pieterseyale-eng/PAROL6-Desktop-robot-arm/3D打印/临时联轴器试装/README.md

# 8 mm 法兰联轴器临时试装件

文件 `8mm法兰联轴器_试装.stl` 可直接导入 Bambu Studio；`8mm法兰联轴器_试装.scad` 是可修改尺寸的参数化源文件。

## 尺寸依据

用户提供的已购商品图：法兰外径 32 mm、厚 3 mm，轴套外径 16 mm、长 10 mm，公称轴孔 8 mm，4 个 4 mm 光孔、对孔中心距 24 mm，侧面 M4 顶丝。原 PAROL6 的 J2、J3、J6 配合 STL 实测也是 4 孔、孔距圆 24 mm。装配手册第 62、94、97 页分别列出 J2、J3、末端的联轴器安装。

打印试装 STL 为适应 FDM，把轴孔放大到 8.2 mm、四个安装光孔放大到 4.2 mm；侧向 M4 顶丝孔为 3.3 mm 打印攻丝底孔。两侧向孔按 90° 分布，是依据图片做的临时假设，到货后以实物为准。若打印机孔径偏小，请先测量，不要硬敲输出轴。

这个打印件只用于孔位、外形、装配空间和低负载手动试配。J2、J3 的实际传扭和承重仍需金属联轴器；不要用打印件通电带载运行机械臂。
