pieterseyale-eng/PAROL6-Desktop-robot-arm/parol6_description （机器人模型说明）/parol6_description/docs/README.md

# Package documentation

[Back to the model instructions](../README.md)

- [Position actuation and open-loop hardware](ACTUATION.md)
- [Model license and attribution](ATTRIBUTION.md)
- [PAROL6 description changelog](CHANGELOG.md)
- [Changing model colors](COLORS.md)
- [Local contact-refinement timing check](CONTACT_PERFORMANCE.md)
- [PAROL6 DH and joint convention](DH.md)
- [PAROL6 dynamics inheritance](DYNAMICS.md)
- [PAROL6 inheritance and normalized-frame validation](DYNAMICS_AUDIT.md)
- [Jaw-specific grasp frames: proposed implementation](GRASP_FRAMES.md)
- [PAR6 and PAROL6: common DH and joint convention](KINEMATICS_COMPARISON.md)
- [PAROL6 kinematic review sheets](KINEMATIC_REVIEW.md)
- [Importing the supplied PAROL6 export](MIGRATION.md)
- [MoveIt 2: plan and preview robot movements](MOVEIT2.md)
- [View from the MSG built-in camera](MSG_CAMERA.md)
- [Pneumatic gripper](PNEUMATIC.md)
- [ROS 2: install and display the models](ROS2.md)
- [SSG48 internal contacts and grasp fixture correction](SSG48_CONTACTS.md)

[Dimensioned SVG/PNG sheets and numeric data](kinematics_review/)
