pieterseyale-eng/PAROL6-Desktop-robot-arm/Docs （项目文档）/wrist_C_B电机插头避让_修改记录.md

# wrist 电机插头避让：B、C 两面开槽

日期：2026-11-11。依据 J6 实物试装照片，两处插头与 `wrist.STL` 开口附近的侧壁干涉。用户根据开口俯视定位图确认需要切 **B 面（+X）与 C 面（+Y）**。

## 几何参数

- 原 STL 坐标单位：mm；开口位于最小 Z，即 `Z = 0.090815`。
- 电机方腔中心按截面取 `X = 30.05`、`Y = 29.10`。
- 每处槽口沿所在侧壁宽 **25 mm**，从开口沿电机轴线向内深 **25 mm**。切除终点为 `Z = 25.090815`。
- C 面槽口：X 为 `17.55～42.55`；切除刀具跨越 Y 为 `46.5～61.5`，穿透该面壁厚。
- B 面槽口：Y 为 `16.60～41.60`；切除刀具跨越 X 为 `48.5～63.5`，穿透该面壁厚。
- 刀具从开口外侧延伸 2 mm，确保完全切开开口边缘；模型的总体包围盒不变。

## 文件

- 原模型：`STL （三维打印模型）/WRIST （腕部）/wrist.STL`
- 修改后的源模型：`STL （三维打印模型）/WRIST （腕部）/wrist_C_B_connector_relief_25x25.STL`
- 当前打印版：`3D打印/分锅STL/锅07_腕部急停盒与J2/wrist_C_B_connector_relief_25x25.STL`
- 原打印版备份：`3D打印/备份/wrist_原版.STL`
- 复现脚本：`3D打印/修改脚本/wrist_C_B_开槽.py`
- 截面对比：`STL （三维打印模型）/WRIST （腕部）/wrist_C_B_开槽截面对比.png`

## 核对结果

- 原版体积 `83455.017 mm³`；新版体积 `76566.660 mm³`；切除约 `6888.358 mm³`。
- 新版为单一连通、闭合网格，外形包围盒未变化。
- 打印副本与新版源模型的 SHA-256 一致：`12db9f6008aab9d4d46d5325466b9ca72d94eb5f18c9e2d8f9e1308a720c1818`。
- 原打印版备份与原始源模型逐字节一致。

首次打印后仍需用实物试装，确认两个插头及线束弯曲半径有足够余量；照片不能提供插头的精确三维尺寸。
