pieterseyale-eng/PAROL6-Desktop-robot-arm/Docs （项目文档）/项目进度.md

# PAROL6 项目进度

更新日期：2026-11-06
当前阶段：**材料已购齐，拓竹 P1S 已调试好，准备开始打印机械件**。

## 已完成

- 已将 PAROL6 官方仓库克隆到本地，在 `dev/custom-controller` 分支开发；官方仓库保留为 `upstream`，个人 fork 为 `origin`。
- 已整理中文采购资料、标准件备货表和中文装配手册。
- 本阶段所需材料已采购齐全（按项目负责人 2026-11-06 的进度确认）。气动末端此前决定暂不做，不计入这一阶段。
- 实验室打印机为 **Bambu Lab P1S**，已完成调试，准备开始打印。
- 已将打印用 STL 按锅整理到 [`3D打印/分锅STL`](../3D打印/分锅STL)，并写了 [P1S 分锅方案](P1S打印分锅方案.md) 和 [打印操作说明](../3D打印/README.md)。分锅 STL 仍需在 Bambu Studio 中按实际耗材、喷嘴和打印板切片。
- 已下载官方 PAROL6 URDF 模型包 v2.18.1，保存在 [`parol6_description` 模型目录](../parol6_description%20%EF%BC%88%E6%9C%BA%E5%99%A8%E4%BA%BA%E6%A8%A1%E5%9E%8B%E8%AF%B4%E6%98%8E%EF%BC%89/parol6_description)。

## 下一步：开始打印

1. 确认零件版本：整件上臂与小平台分体上臂二选一；J1 标准件与改装件按实际方案选用，避免重复打印。
2. 按锅将对应 STL 一起导入 Bambu Studio，选择 P1S 和实际 PETG 耗材配置，核对方向、支撑、零件间距与切片预览后再打印。
3. 记录每锅打印结果及尺寸配合问题；承力件和轴承座先试装，再继续后续锅次。
4. J6 将使用张大头闭环电机相关方案，原估算轴向长度为减速器 55 mm＋电机 23 mm＋尾部控制板约 20 mm，合计约 98 mm（不含输出轴）。Link5/J6 机械结构仍需按实物尺寸修改；现有 J6 原版打印件不应视作最终改版件。

## 本阶段记录原则

- 本页记录实际进度；采购金额在本目录的 `PAROL6_采购财务台账.xlsx` 中单独记录。
- 打印结束后，在本页补记每锅日期、材料、是否成功、返工件和装配发现。
