pieterseyale-eng/PAROL6-Desktop-robot-arm/Docs （项目文档）/P1S打印分锅方案.md

# PAROL6 × 拓竹 P1S 打印分锅方案

设备：Bambu Lab P1S，标称成型空间 256 × 256 × 256 mm（[拓竹官方产品页](https://bambulab.com/en/p1)）。下表尺寸为当前仓库 STL 网格包围盒，单位 mm；并非推荐朝向下的实际占板尺寸。此方案是分锅草案，尚未在 Bambu Studio 实际排版。

## 打印前的选择

- 正常版主体件可逐件放入 P1S。整件 `Upper_arm.STL` 包围盒为 102 × 231 × 28 mm，长边沿平台 256 mm 方向摆放时只剩约 12.5 mm 总余量；建议单独打印并检查裙边、Brim 和边缘避让。
- 小平台目录中的分体上臂是整件上臂的替代方案，不要两套都打印。J1 标准件、rework blocker 和 small-bed 分体件也应按所选结构版本择一。
- 气动/真空夹爪附件暂不列入主体打印计划。
- 主体结构件建议使用 PETG，并遵循耗材厂商的温度、干燥要求和项目打印参数。具体温度、墙数、填充率要按实际耗材和切片结果设定，不能把单一值视为所有 PETG 通用参数。

## 正常整件方案分锅

| 锅次 | 零件（各 1 件，除注明外） | 摆放建议 |
|---|---|---|
| 1 底座主件 | `main_base_blocker` (118×107×70)；`Electronics_case_v1_1` (109×60×130)；`fan_cover` (53×60×22) | 两个主件在同板排布，检查 brim 是否干涉；风扇盖填边角空位。若大件需要大量支撑，拆成两锅更稳妥。 |
| 2 底座盖和 J1 小件 | `lid_electronics` (105×107×10)；`J1_bottom_lid` (62×63×5)；`J1_rotation_shaft` (35×41×35)；`J1_turret_motor_holder` (55×20×55)；`J1_backplate` (46×7×46) | 薄盖平放；轴/支架依受力方向摆放。检查支撑不要堵紧固孔。 |
| 3 J1 改装大件 | `J1_turret_rework_blocker` (114×175×75) | 单独打印并检查支撑、Brim 和受力层向。仅在选用该 rework 结构时打印；标准 J1 方案不要重复打。 |
| 4 上臂 | `Upper_arm` (102×231×28)；可搭 `38_pulley_J3` (40×40×38)、`J3_limit_switch_cover` (40×32×7)、`Upper_arm_wires_cover` (39×33×7) | 上臂单独占主要区域，长边沿 256 mm 方向。小件只在摆盘后仍有充分间隙时加入。采用分体上臂时改打 A/B 两段，不打整件。 |
| 5 肘部和 J4 | `Elbow_part` (65×102×107)；`Elbow_lid_1` (65×67×8)；`Elbow_lid_2` (48×29×3)；`J4_bearing_backplate` (38×38×6)；`J4_limiter` (10×12×6)；`J4_output_pulley` (45×45×60) | 肘部主件摆放优先考虑层间受力；盖板和滑轮可尝试同锅。核对轴承/轴孔方向及支撑可拆性。 |
| 6 前臂和 J5 | `J5_part` (134×71×74)；`J5_belt_lid` (121×57×15)；`J5_electronics_lid` (50×71×38)；`HTD3_48_J5_pulley` (45×45×26) | 大件和盖、滑轮尝试同锅，使用切片器排版并检查部件间距。若支撑复杂可把盖板/滑轮移到下一锅。 |
| 7 腕部、急停盒、J2 | `wrist` (57×54×81)；`ESTOP_BOTTOM` (48×48×24)；`ESTOP_TOP` (48×21×48)；`J2_bearing_backplate` (47×6×47)；`J2_cover` (60×12×60)；`J2_shaft` (35×48×35)；`J2_stopper_block` (40×46×11)；`J2_limit_switch_cover` (40×21×5)；`42_pulley` (16×41×41) | 小中件可尝试同板。腕部与轴件按受力层向摆放；若板面过密，分成两锅降低整板失败风险。 |
| 8 小辅件/补打 | `connectors_4_alu_profiles` (30×30×30)；`J1_wires_cover_rework` (9×106×6) 及最终选定版本所需小件 | 可填入其他锅次的空位。rework 线盖只在对应改装方案下打印。 |

## 小平台分体替代件

- 上臂：`SMALL_PRINT_BED/Upper_arm/Upper_arm_A_long_end` (82×162×28) 与 `Upper_arm_B_short_end` (77×88×28) **替代** `Upper_arm.STL`。可将 A 段与一锅主件同板，B 段与盖板/小件同板，但须在切片器确认占板与受力方向。
- J1：`J1_turret_rework_blocker_A_turret_end` (100×105×53) 与 `_B_arm_end` (114×80×75) 替代整体 rework blocker。按该目录 README 和小平台改装手册核定配套关系，不要当作额外加强件打印。

## P1S 上机核对

1. 在 Bambu Studio 选择 P1S 与实际喷嘴，逐锅导入并自动排版；逐件检查朝向、Brim、支撑、孔位和部件间距。
2. 先打印 `Elbow_part`、`J5_part` 等配合/承力复杂件样件，检查孔轴、轴承座、层间裂纹和装配尺寸，再批量打印。
3. PETG 先按线轴厂商说明干燥，并使用相应耗材配置；按拓竹对设备和耗材的建议控制腔温与通风。不同品牌耗材参数可能不同。
4. 项目打印说明和打印参数表作为强度设置参考；最终耗材、工时、支撑和裙边由切片器预览确认。提高填充率不能替代正确打印方向和外墙设计。
5. 打印时记录实际方向、耗材和失败/返工件；不同受力方向或支撑策略差异大的关键件可拆锅。

## 范围和限制

本方案根据 STL 网格包围盒作初步分组，未生成 3MF，也未计算实际耗材或工时。STL 自带方向未必是最佳打印方向；悬垂、支撑、Brim 与平台边缘余量必须由 Bambu Studio 确认。仓库包含替代件和夹爪附件，45 个 STL 不等于 45 个装机件；请按所选机械版本、README 和装配手册确定实际打印清单。
