pieterseyale-eng/PAROL6-Desktop-robot-arm/Docs （项目文档）/目录中英对照.md

# 目录中英对照

目录保留英文原名，并附加中文说明。文件名保持不变。
本次范围：项目根目录的普通文件夹，以及物料清单、STL、扩展功能和模型说明中的分类目录。
Git 管理目录、`.github` 和源码内部工具/第三方库目录保留约定名称。
官方镜像 `../../PAROL6-official.git` 保留原始目录结构。

| 原目录 | 当前目录 |
| --- | --- |
| `BOM` | `BOM （物料清单）` |
| `BOM/BOM reference images` | `BOM （物料清单）/BOM reference images （物料参考图片）` |
| `Building instructions` | `Building instructions （装配说明）` |
| `Docs` | `Docs （项目文档）` |
| `Extras` | `Extras （扩展功能）` |
| `Extras/LEAP motion control code` | `Extras （扩展功能）/LEAP motion control code （LEAP手势控制代码）` |
| `Images` | `Images （图片资料）` |
| `PAROL6 control board main software` | `PAROL6 control board main software （主控正式固件）` |
| `PAROL6 control board test code` | `PAROL6 control board test code （主控测试固件）` |
| `Print table` | `Print table （打印参数表）` |
| `STL` | `STL （三维打印模型）` |
| `STL/BASE` | `STL （三维打印模型）/BASE （底座）` |
| `STL/ELBOW` | `STL （三维打印模型）/ELBOW （肘部）` |
| `STL/ESTOP` | `STL （三维打印模型）/ESTOP （急停盒）` |
| `STL/FOREARM` | `STL （三维打印模型）/FOREARM （前臂）` |
| `STL/GRIPPER_ATTACHMENTS` | `STL （三维打印模型）/GRIPPER_ATTACHMENTS （夹爪连接件）` |
| `STL/GRIPPER_ATTACHMENTS/Horizontal pneumatic gripper` | `STL （三维打印模型）/GRIPPER_ATTACHMENTS （夹爪连接件）/Horizontal pneumatic gripper （水平气动夹爪）` |
| `STL/SHOULDER` | `STL （三维打印模型）/SHOULDER （肩部）` |
| `STL/SMALL_PRINT_BED` | `STL （三维打印模型）/SMALL_PRINT_BED （小尺寸打印平台）` |
| `STL/SMALL_PRINT_BED/J1_turret_rework_blocker` | `STL （三维打印模型）/SMALL_PRINT_BED （小尺寸打印平台）/J1_turret_rework_blocker （J1转台限位件）` |
| `STL/SMALL_PRINT_BED/Upper_arm` | `STL （三维打印模型）/SMALL_PRINT_BED （小尺寸打印平台）/Upper_arm （上臂）` |
| `STL/UPPER_ARM` | `STL （三维打印模型）/UPPER_ARM （上臂）` |
| `STL/UTILITY` | `STL （三维打印模型）/UTILITY （辅助零件）` |
| `STL/WRIST` | `STL （三维打印模型）/WRIST （腕部）` |
| `STL/mounting plates` | `STL （三维打印模型）/mounting plates （安装板）` |
| `parol6_description` | `parol6_description （机器人模型说明）` |
| `parol6_description/previews` | `parol6_description （机器人模型说明）/previews （预览图）` |
