pieterseyale-eng/PAROL6-Desktop-robot-arm/硬件资料/张大头/PAROL6选型与控制方案.md

# 张大头闭环步进资料与 PAROL6 适配结论

## 归档资料

本文件夹收录：

- `ZDT_X42S第二代闭环步进电机用户手册V1.0.5_260527.pdf`：X42S 说明书，110 页。
- `ZDT闭环步进电机MODBUS协议使用说明V1.0.1_260818.pdf`：Modbus-RTU 通讯手册。
- `ZDT闭环步进电机选型表_251105.jpg`：文件名叫“选型表”，图中实际内容主要是 X42_V1.3、X42S_V1.0、Y42_V2.0 板卡与 Emm/X 固件对比，不是电机尺寸/扭矩选型表。

## 先给结论

张大头 X42S 的闭环驱动和通讯能力可以接入自研主控，方向上适合做六轴的位置控制；但当前这批资料**不足以确认你准备购买的五个具体电机够不够 PAROL6 承载，也不足以确认其外形能否装进 J1–J5**。资料说的是驱动板能力，缺少所选 42 磁柱电机型号对应的保持/动态扭矩曲线、机身长度、轴径与轴伸，以及装上编码器板后的总长。建议向商家明确要逐个电机型号的尺寸图与转速-扭矩曲线，并询问能否 X42S_V1.0 驱动板与配套磁柱电机整套安装校准发货。

## 怎么控制：建议架构

推荐每轴一套“42 步进电机 + X42S 闭环驱动板”，主控 MCU 用 **CAN 总线**连接五轴（未来第六轴也一样接入）。CAN 线采用总线拓扑，所有节点共用 CAN_H、CAN_L 和信号地，配置唯一节点地址/ID，并只在总线两端按手册要求配置终端电阻。若买到的是 RS485 版本，则使用 RS485 差分总线与唯一电机地址；不要买错通讯小板/集成接口版本。TTL 更适合短距离台架测试，不作为整臂首选。

控制层由你自己的主控产生每个关节的目标角度/速度/加速度；驱动器内部负责电机电流、编码器反馈和位置闭环。主控读取实际位置、位置误差、转速、状态/报警及温度等反馈，做状态机和故障处理。X42S 手册说明支持 CAN/RS485/TTL 通讯、位置/速度/力矩等模式、周期状态回传、多电机命令和同步启动。开发初期可先用厂家自由协议跑通，再考虑 Modbus-RTU；Modbus 通讯手册单独列出了读状态寄存器、读写参数等方法。若采用 CAN，要按主手册 CAN 帧格式而不是把 Modbus RTU 帧直接塞进 CAN。

关节目标角度的换算要放在你的主控里：

- J1（皮带）：电机角度和关节角度按 96/15 的带轮比换算。
- J2：电机经 20:1 行星减速器，关节角约为电机角度 / 20。
- J3：行星减速器与带传动组合，仓库现有配置约 18.095:1（20 × 42/38）；具体正负方向按装配后标定。
- J4/J5（皮带）：按实际电机轮/关节轮齿数换算；原机械参考电机 12T，主传动轮分别需对照 CAD/BOM 复核。

上面只给理想传动比例，运动方向、零位偏置和限位范围要在组装后逐轴标定。**电机端编码器不等于关节输出端绝对角度传感器**：减速器回差、皮带弹性和连杆形变仍在编码器测量之外。若要评估真实末端误差，后续可在关键关节输出侧加编码器。

## 推荐购买/下单配置

1. 询价时先明确要 **X42S_V1.0**（不要误买旧 X42_V1.3；后者已停产）及通讯接口版本。若自研板支持 CAN，优先询价 CAN 集成/套件；问清总线速率、接口针脚、线束和节点地址设置方式。
2. J1–J5 暂按仓库机械尺寸寻找匹配的 42 系列步进电机：J1/J2 原参考机身约 60 mm，J3/J4/J5 原参考约 40 mm。需厂家确认“装驱动器/编码器后的总长”，不能只看 42 mm 法兰或电机裸机身长度。
3. J2/J3 需保留/适配原有 NEMA17 20:1 行星减速器。下单前确认 X42S 配套电机的轴径、轴伸、前端法兰和螺钉孔与减速器输入兼容；J3 的总传动比还包含皮带级。
4. J1/J4/J5 保留皮带级时，需确认输出轴加工形状、齿轮/同步轮紧固方式与电机空间。闭环板在电机尾部的空间也要纳入机构包络。
5. J6 由你调整 Link5 机械结构，可与五轴分开选型；不要因同属 42 系列就认为 J6 也能用相同长度/扭矩版本。
6. 扭矩不能凭 X42S 驱动板最大电流推断。先根据臂展和各轴重力力矩选电机，再用厂家动态扭矩曲线核对低速连续保持与运动速度下的输出；肩部还要计入整条手臂自重、夹爪和加速度。

## 调试顺序建议

1. 单独给每套驱动板和电机接线，检查绕组线序、供电版本与接口板版本；严禁带电插拔电机/电源/通讯线。
2. 电机与驱动板按厂家要求装好后，先在空载条件下做编码器/电机校准；拆过板、换过电机后重新校准。
3. 在桌面固定、低速度、小角度下用通讯工具测试单轴：使能、目标位置、停止、读实际位置、读状态和报警。
4. 给每轴配置唯一地址；单轴稳定后再测试总线多轴命令与同步启动。
5. 装到机械臂后逐轴校零、限位和方向，验证急停/掉线处理及软限位，再低速试整臂。

## 需要卖家补齐的资料

- J1/J2 长机身候选和 J3/J4/J5 中机身候选的准确型号与价格。
- 每个型号的整机尺寸图（含编码器/驱动板）、轴径/轴伸/扁位、安装孔距。
- 保持扭矩及动态扭矩-转速曲线，额定电流和建议电源。
- X42S_V1.0 的具体通讯接口选择：CAN 或 RS485，是否集成，线序/端子图和配套线缆。
- CAN/RS485 的多机控制例程、默认 ID、波特率、应答模式，以及同步命令在该固件版本下的支持方式。
- 五套电机与驱动板能否整套安装、校准后发货；若自行安装，所需磁铁/胶、间隙和校准步骤。
