pieterseyale-eng/PAROL6-Desktop-robot-arm/parol6_description （机器人模型说明）/parol6_description/docs/ATTRIBUTION.md

# Model license and attribution

Copyright 2026 Source Robotics.

The robot/gripper descriptions, geometry, textures, physical data and
documentation in this package are licensed under **CC-BY-4.0**.
See the [full model license](../LICENSE).

Source: [Source Robotics robot_descriptions](https://github.com/Source-Robotics/robot_descriptions).
License: [Creative Commons Attribution 4.0 International](https://creativecommons.org/licenses/by/4.0/).

When sharing the models or adaptations, credit Source Robotics, link to the
source and license, retain supplied notices, and indicate your changes.
For example:

> Robot models by Source Robotics, https://github.com/Source-Robotics/robot_descriptions,
> CC BY 4.0, https://creativecommons.org/licenses/by/4.0/.
> Changes: describe your modifications, or state that none were made.

ROS launch/support scripts and CMake code are Apache-2.0; see [LICENSE-CODE.txt](LICENSE-CODE.txt).
