pieterseyale-eng/PAROL6-Desktop-robot-arm/Docs （项目文档）/法兰联轴器_已购商品尺寸图.png

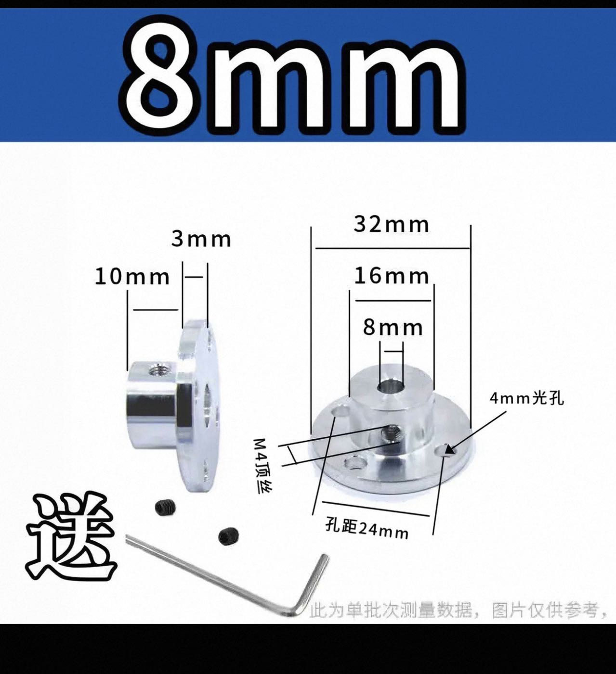
Docs （项目文档）/法兰联轴器_已购商品尺寸图.png
