pieterseyale-eng/PAROL6-Desktop-robot-arm/Docs （项目文档）/螺钉头型参考图/cross_pan_head_reference.png

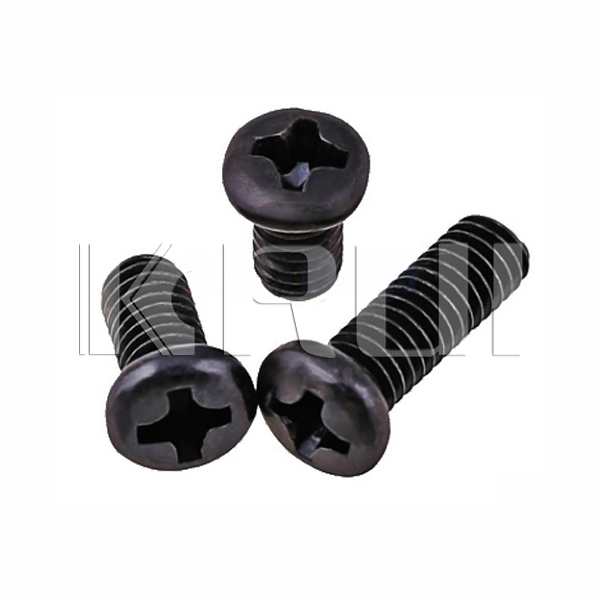
Docs （项目文档）/螺钉头型参考图/cross_pan_head_reference.png
