pieterseyale-eng/PAROL6-Desktop-robot-arm/Docs （项目文档）/螺钉头型参考图/low_profile_head_reference.webp

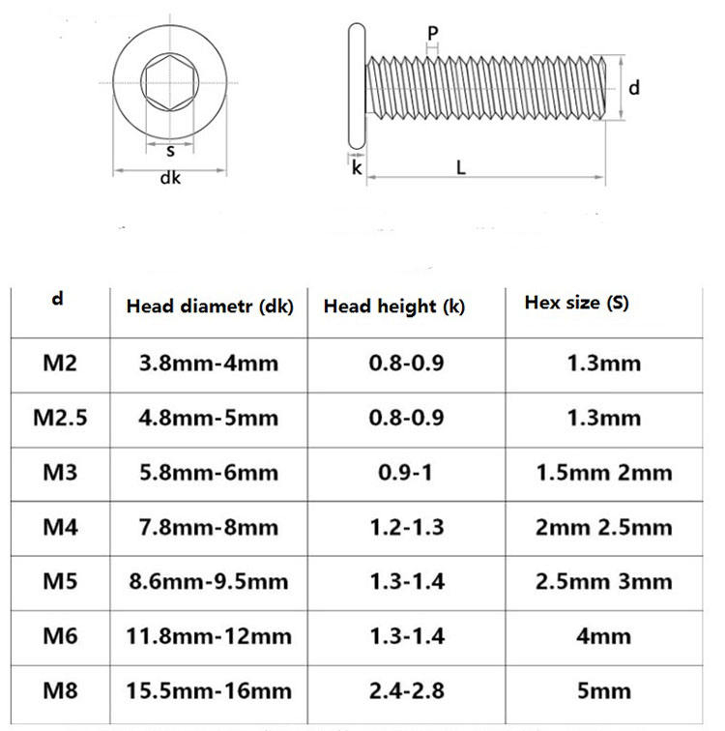
Docs （项目文档）/螺钉头型参考图/low_profile_head_reference.webp
