pieterseyale-eng/PAROL6-Desktop-robot-arm/Docs （项目文档）/螺钉头型参考图/tapered_head_reference.jpeg

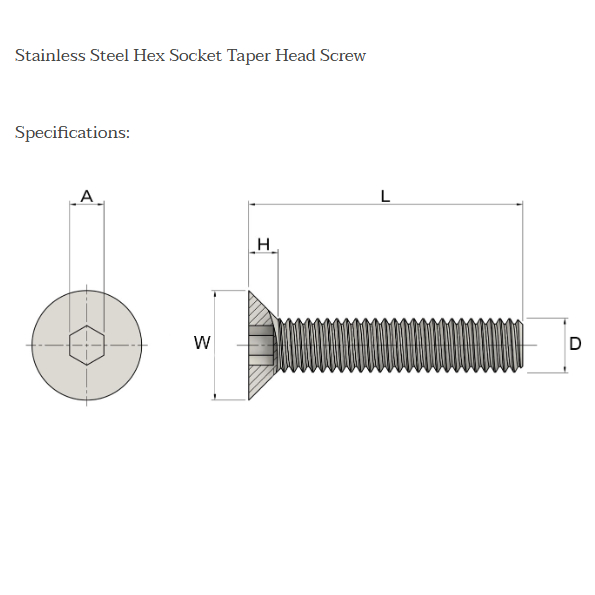
Docs （项目文档）/螺钉头型参考图/tapered_head_reference.jpeg
