pieterseyale-eng/PAROL6-Desktop-robot-arm/parol6_description （机器人模型说明）/parol6_description/docs/kinematics_review/pneumatic.png

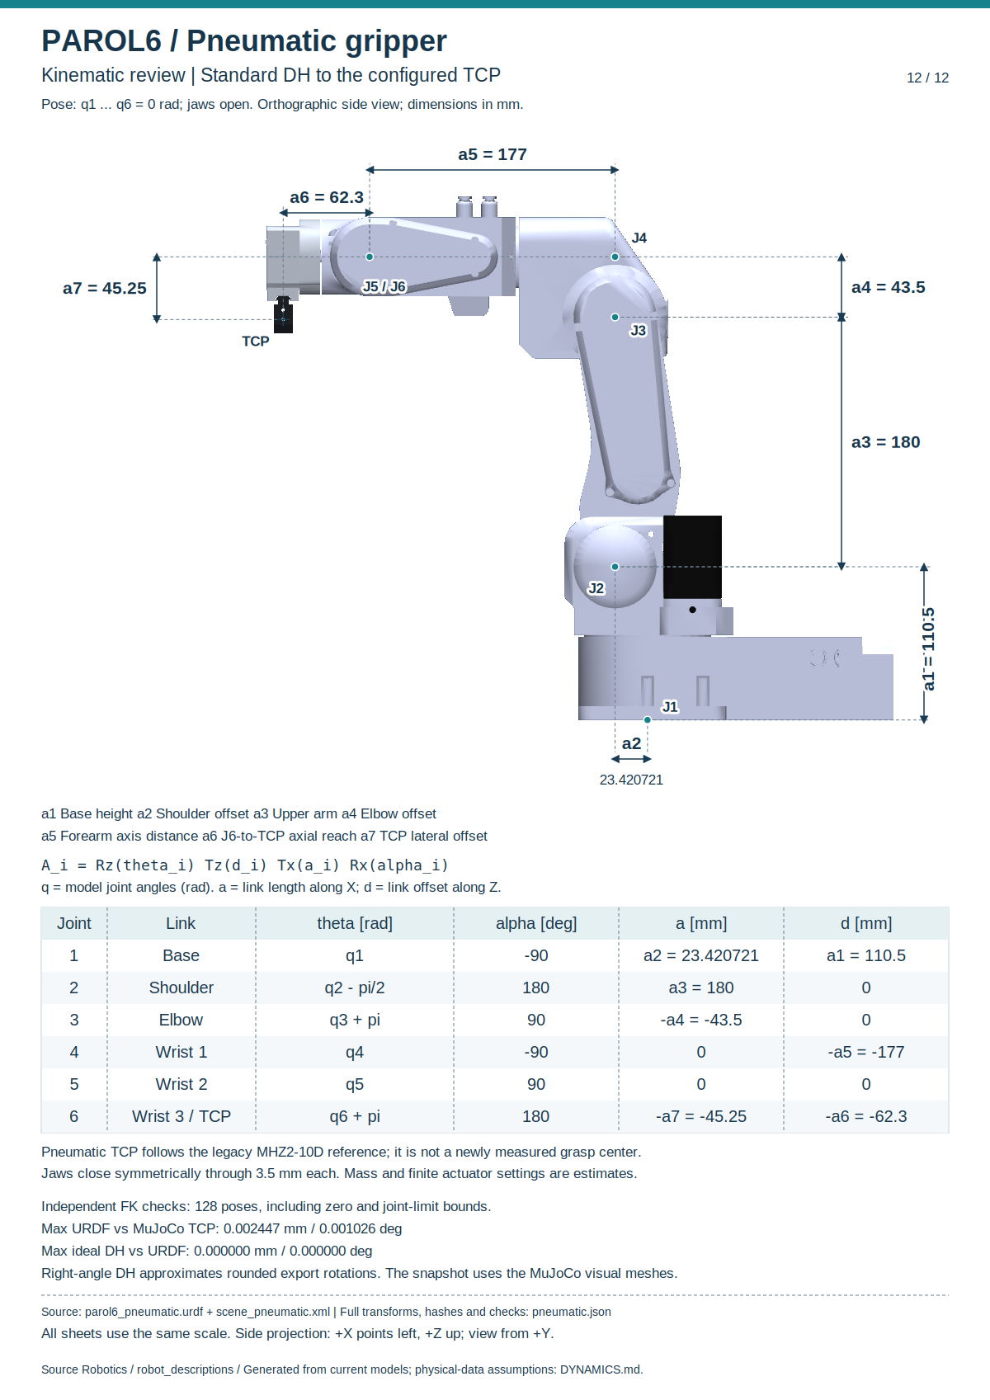
parol6_description （机器人模型说明）/parol6_description/docs/kinematics_review/pneumatic.png
