pieterseyale-eng/PAROL6-Desktop-robot-arm/STL （三维打印模型）/ELBOW （肘部）/Elbow_part_connector_relief_left_28_25_正视预览.png

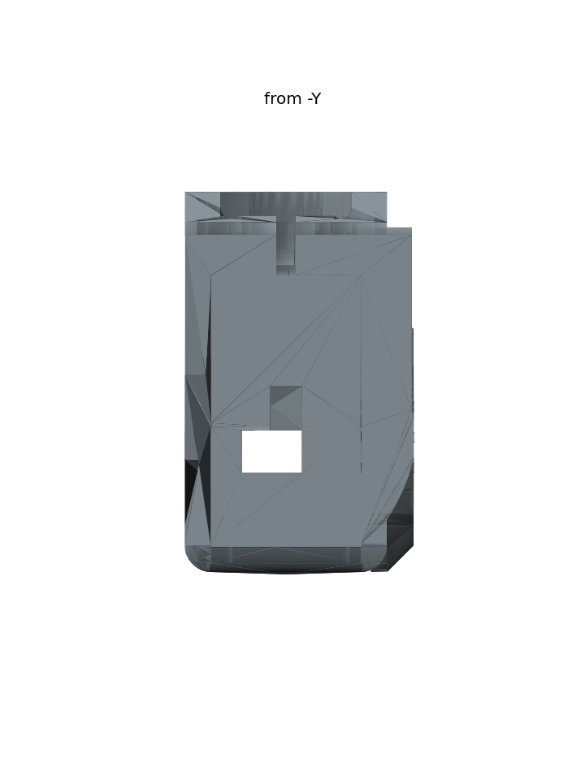
STL （三维打印模型）/ELBOW （肘部）/Elbow_part_connector_relief_left_28_25_正视预览.png
