pieterseyale-eng/PAROL6-Desktop-robot-arm/STL （三维打印模型）/ELBOW （肘部）/Elbow_part_motor_cavity_deeper30mm_截面对比.png

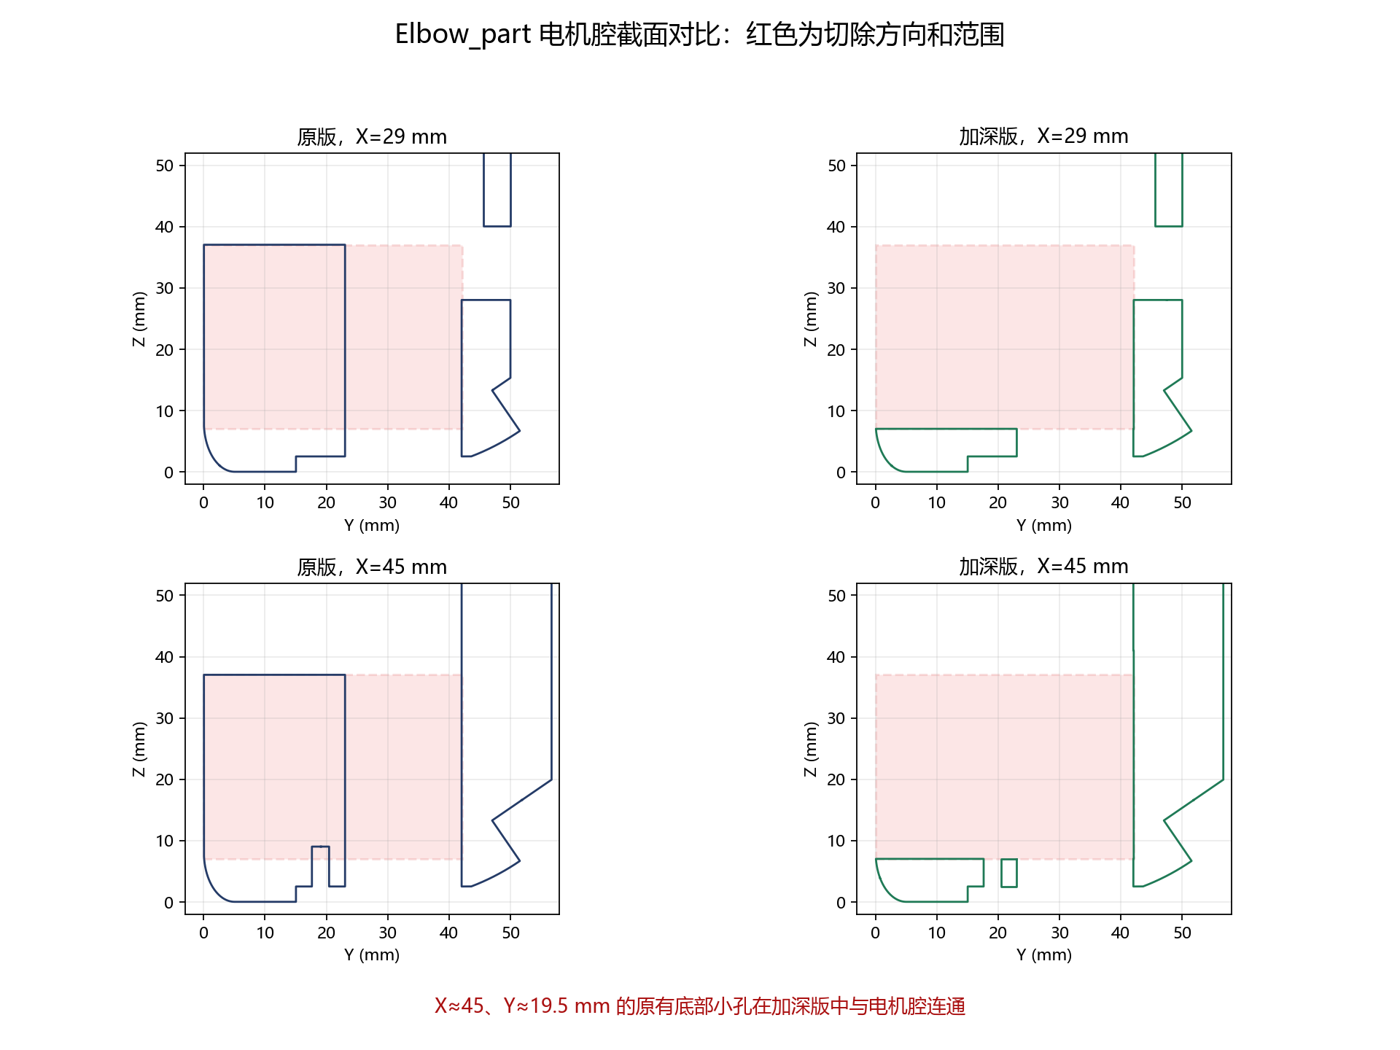
STL （三维打印模型）/ELBOW （肘部）/Elbow_part_motor_cavity_deeper30mm_截面对比.png
