pieterseyale-eng/PAROL6-Desktop-robot-arm/STL （三维打印模型）/FOREARM （前臂）/J5_part_J6_plus30mm_v2_底部对比预览.png

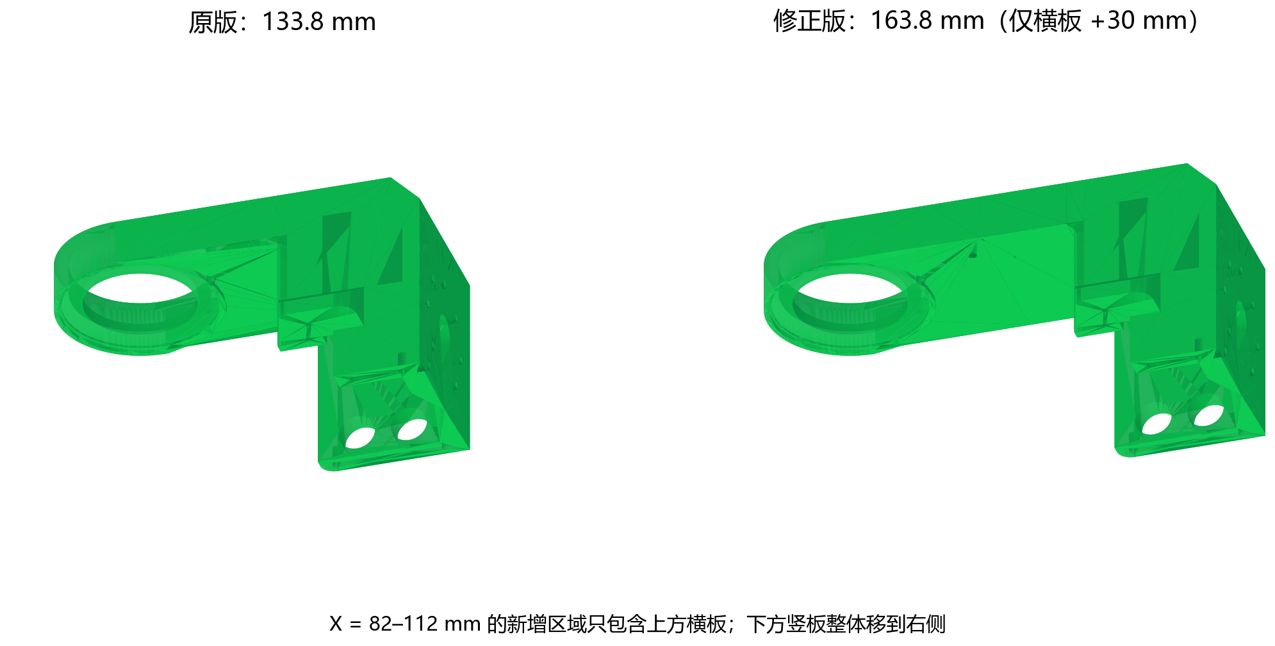
STL （三维打印模型）/FOREARM （前臂）/J5_part_J6_plus30mm_v2_底部对比预览.png
