pieterseyale-eng/PAROL6-Desktop-robot-arm/STL （三维打印模型）/FOREARM （前臂）/J5_part_J6_plus30mm_v3_孔洞与避让对比.png

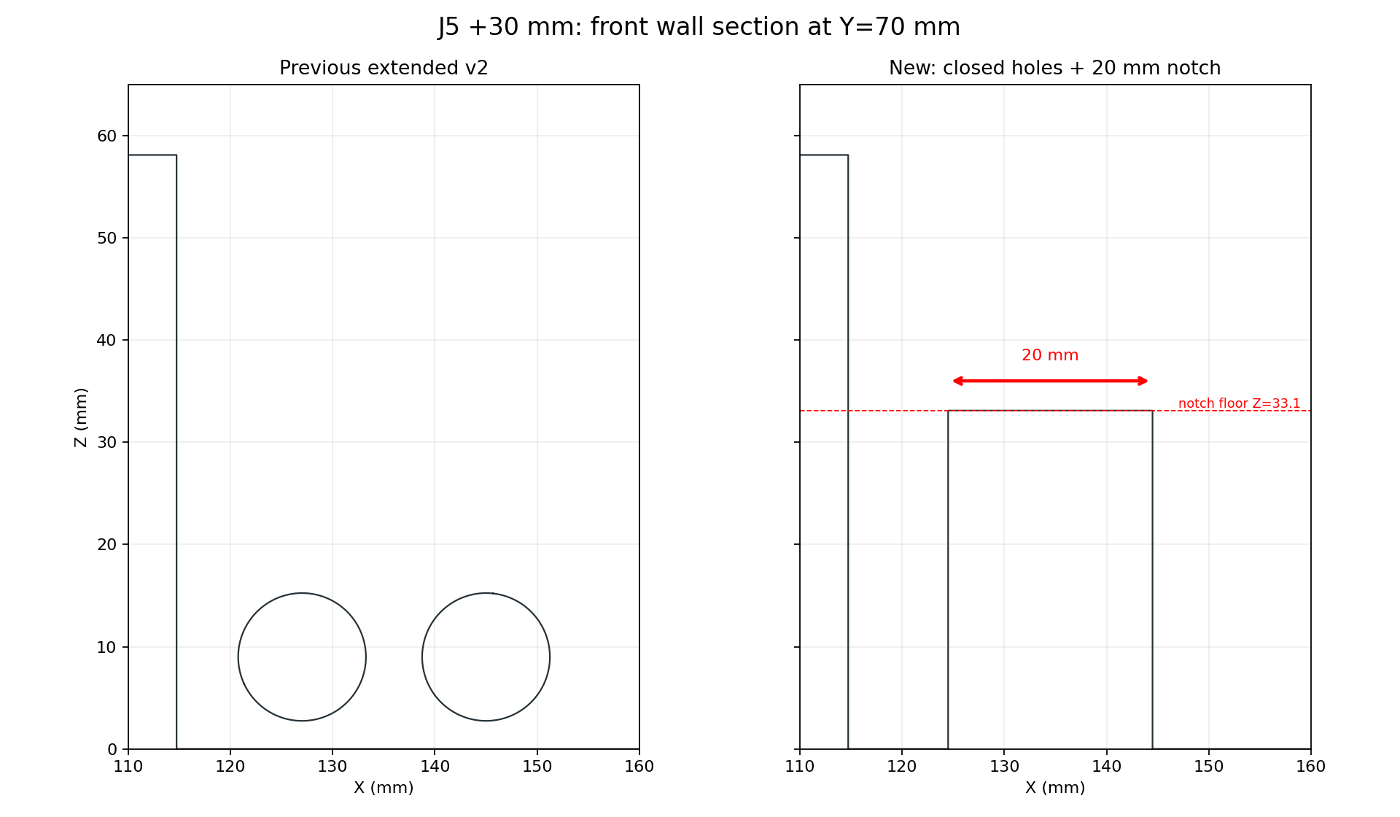
STL （三维打印模型）/FOREARM （前臂）/J5_part_J6_plus30mm_v3_孔洞与避让对比.png
