pieterseyale-eng/PAROL6-Desktop-robot-arm/STL （三维打印模型）/WRIST （腕部）/wrist_C_B_开槽截面对比.png

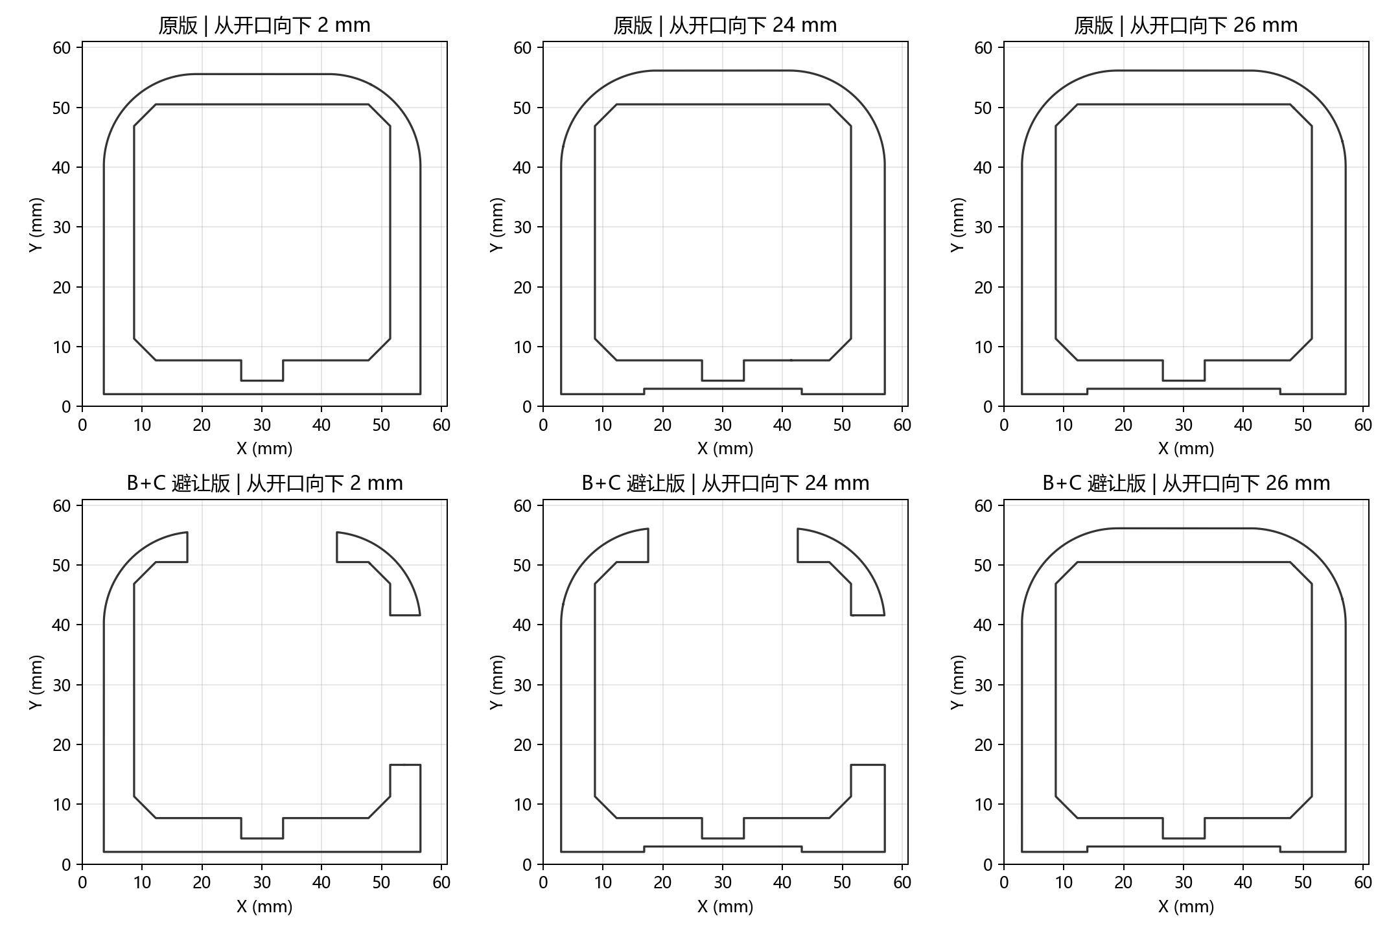
STL （三维打印模型）/WRIST （腕部）/wrist_C_B_开槽截面对比.png
