pieterseyale-eng/PAROL6-Desktop-robot-arm/硬件资料/电机减速器参考图/g10_0.jpg

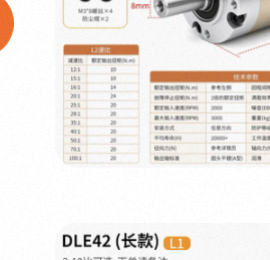
硬件资料/电机减速器参考图/g10_0.jpg
