pieterseyale-eng/PAROL6-Desktop-robot-arm/Docs （项目文档）/采购清单_BOM核对.md

# PAROL6 采购清单与 BOM 核对

核对日期：2026-11-05。基线提交：`b09bd3b732695f3f34252ca2f7c5ffbeeda8f073`。适用目标：沿用仓库当前机械结构，自己设计主控板、自己编写固件。

**可以先采购电机、减速器、轴承、同步带、同步轮和紧固件；官方主控板、官方编程转接板不列为必买。驱动器、主控芯片及其接口器件，要等自己的电路方案确定后再出板级 BOM。** 本文是零件与规格核对，不含实时价格、库存或代购承诺。

## 1. 来源与数量的含义

| 来源 | 本次用途 |
| --- | --- |
| [BOM/BOM.md](../BOM%20%EF%BC%88%E7%89%A9%E6%96%99%E6%B8%85%E5%8D%95%EF%BC%89/BOM.md) | 采购数量与原始规格的主要依据；该文件含原采购链接和参考图片 |
| [装配手册](../Building%20instructions%20%EF%BC%88%E8%A3%85%E9%85%8D%E8%AF%B4%E6%98%8E%EF%BC%89/Parol%20building%20instructions.pdf) | 101 页；本文页码为 PDF 页码，与页面印刷数字一致；核对关节用途、线长和漏项 |
| [打印参数工作簿](../Print%20table%20%EF%BC%88%E6%89%93%E5%8D%B0%E5%8F%82%E6%95%B0%E8%A1%A8%EF%BC%89/PR_EXCEL.xlsx) | 只读检查 `3D printed parts stats` 和 `Wire_markings`；不作为采购 BOM |
| [打印参数 PDF](../Print%20table%20%EF%BC%88%E6%89%93%E5%8D%B0%E5%8F%82%E6%95%B0%E8%A1%A8%EF%BC%89/Print_table.pdf) | 打印设置的另一入口，与工作簿有重复和旧名称问题 |
| [PETG 打印说明](../Building%20instructions%20%EF%BC%88%E8%A3%85%E9%85%8D%E8%AF%B4%E6%98%8E%EF%BC%89/PETG_printing.md) | 材料和打印条件 |
| [小平台改装说明](../STL%20%EF%BC%88%E4%B8%89%E7%BB%B4%E6%89%93%E5%8D%B0%E6%A8%A1%E5%9E%8B%EF%BC%89/SMALL_PRINT_BED%20%EF%BC%88%E5%B0%8F%E5%B0%BA%E5%AF%B8%E6%89%93%E5%8D%B0%E5%B9%B3%E5%8F%B0%EF%BC%89/README.md)及[改装手册](../Building%20instructions%20%EF%BC%88%E8%A3%85%E9%85%8D%E8%AF%B4%E6%98%8E%EF%BC%89/Parol%20small%20print%20bed%20modification.pdf) | 仅在整件放不进打印机时使用 |
| [固件 constants.h](../PAROL6%20control%20board%20main%20software%20%EF%BC%88%E4%B8%BB%E6%8E%A7%E6%AD%A3%E5%BC%8F%E5%9B%BA%E4%BB%B6%EF%BC%89/src/constants.h)、[main.cpp](../PAROL6%20control%20board%20main%20software%20%EF%BC%88%E4%B8%BB%E6%8E%A7%E6%AD%A3%E5%BC%8F%E5%9B%BA%E4%BB%B6%EF%BC%89/src/main.cpp)、[iodefs.h](../PAROL6%20control%20board%20main%20software%20%EF%BC%88%E4%B8%BB%E6%8E%A7%E6%AD%A3%E5%BC%8F%E5%9B%BA%E4%BB%B6%EF%BC%89/src/iodefs.h) | 确认官方参考方案为六轴步进、六路归零输入、TMC5160；不据此锁定自研方案 |

表中的“BOM 数量”照录官方数量。尤其螺钉、小张紧轴承可能包含余量，并非逐步装配净用量；电商“1 件”可能是一包、一对或一个套装，必须换算实物数量。本文没有把未核实的包装量当成装机量。

## 2. 电机与减速器：优先下单，先核安装尺寸

来源：[BOM Motors](../BOM%20%EF%BC%88%E7%89%A9%E6%96%99%E6%B8%85%E5%8D%95%EF%BC%89/BOM.md#motors)、[BOM Gearboxes](../BOM%20%EF%BC%88%E7%89%A9%E6%96%99%E6%B8%85%E5%8D%95%EF%BC%89/BOM.md#gearboxes)；关节对应关系由装配手册第 21、29、41、53、60、66、77 页交叉核对。

| 采购项 | 原 BOM 规格 / 参考型号 | BOM 数量 | 用途与下单核对 |
| --- | --- | --- | --- |
| NEMA 17 小电机 | 16 N·cm，42×42×20 mm；`17HS08-1004S`；链接标注 1 A、1.8°、4 线 | 1 台 | J6，接 10:1 减速器。本轮补核现售机身21.5 mm、轴伸20 mm；与BOM及减速器输入轴长范围有差异，配套确认后再购 |
| NEMA 17 中电机 | 45 N·cm，42×42×40 mm；`17HS16-2004S1`，2 A、4 线 | 3 台 | J3/J4/J5；J3 接 20:1 减速器，J4/J5 接 12 齿同步轮 |
| NEMA 17 长电机 | BOM 写 65 N·cm，42×42×60 mm；`17HS24-2104S`，2.1 A、4 线 | 2 台 | J1/J2。**现行供应商页面写 76 N·cm，与 BOM 不一致**，不能据此自动认定为升级或可直接替换；按型号、尺寸、电流、轴和实物资料确认 |
| 精密行星减速器 | NEMA 17，20:1；`EG17-G20` | 2 台 | J2/J3；供应商标称空载回差 ≤20 arcmin |
| 精密行星减速器 | NEMA 17，10:1；`EG17-G10` | 1 台 | J6；供应商标称空载回差 ≤15 arcmin |

**总计 6 台电机＋3 个独立减速器，不是 6 台减速电机。** 如购买电机与减速器一体总成，扣除重复项。官方 BOM 提到更便宜的 MG 系列，但回差更大；没有完成尺寸与性能复核前，不按相同减速比直接替代。

已核对的供应商资料：

- [EG17-G20](https://www.omc-stepperonline.com/eg-series-planetary-gearbox-gear-ratio-20-1-backlash-20-arc-min-for-nema-17-stepper-motor-eg17-g20) 与 [EG17-G10](https://www.omc-stepperonline.com/eg-series-planetary-gearbox-gear-ratio-10-1-backlash-15-arc-min-for-nema-17-stepper-motor-eg17-g10)：输入匹配 Φ5 mm、轴长 21.5–25 mm；输出轴 Φ8 mm、轴伸 21.5 mm；减速器长度分别 67 mm、55 mm。内有输入联轴结构。安装面、孔距、轴伸、键槽与电机轴尺寸都应按尺寸图验收。
- [中电机官方商品页](https://www.omc-stepperonline.com/nema-17-bipolar-45ncm-64oz-in-2a-42x42x40mm-4-wires-w-1m-cable-connector-17hs16-2004s1)及[长电机原 BOM 商品页](https://www.omc-stepperonline.com/nema-17-bipolar-1-8deg-65ncm-92oz-in-2-1a-3-36v-42x42x60mm-4-wires-17hs24-2104s)：长电机页面 URL 仍含 65ncm，页面现值却为 76 N·cm，不可只看链接文字。

装配手册第 18、21 页说明：**连接电机和减速器的螺钉使用减速器随附件**。询价时确认这套螺钉、输入联轴紧定螺钉都包含在内。

## 3. 同步带、同步轮和法兰联轴器

来源：[BOM Belts](../BOM%20%EF%BC%88%E7%89%A9%E6%96%99%E6%B8%85%E5%8D%95%EF%BC%89/BOM.md#belts)、[Pulleys](../BOM%20%EF%BC%88%E7%89%A9%E6%96%99%E6%B8%85%E5%8D%95%EF%BC%89/BOM.md#pulleys)、[Shaft couplers](../BOM%20%EF%BC%88%E7%89%A9%E6%96%99%E6%B8%85%E5%8D%95%EF%BC%89/BOM.md#shaft-couplers)；装配手册第 43、62–64、81、93–98 页。

| 采购项 | 规格 | BOM 数量 | 备注 |
| --- | --- | --- | --- |
| J1 闭环同步带 | HTD 3M，节线长 396 mm，宽 6 mm | 1 条 | 132 齿，由 396÷3 换算 |
| J3 闭环同步带 | HTD 3M，节线长 342 mm，宽 6 mm | 1 条 | 114 齿 |
| J4 闭环同步带 | HTD 3M，节线长 201 mm，宽 6 mm | 1 条 | 67 齿 |
| J5 闭环同步带 | HTD 3M，节线长 246 mm，宽 6 mm | 1 条 | 82 齿 |
| J4/J5 金属同步轮 | HTD3M，12 齿，孔径 5 mm，BOM 标“10 mm width” | 2 个 | 两关节各 1；下单确认“10 mm”是齿面宽还是总宽，并核轴向空间及紧定螺钉 |
| J1 金属同步轮 | HTD3M，15 齿，孔径 5 mm，BOM 标“10 mm width” | 1 个 | 同上 |
| 输出法兰联轴器 | 中心孔 8 mm，M4 安装孔 | 3 个 | 按参考图买刚性法兰式，不能误买普通双孔柔性联轴器；核法兰孔距、孔数、外径和紧定螺钉位置 |

**不要买成 GT2 或 GT3 带；3M 表示 3 mm 齿距。** 三个法兰联轴器包括 J2、J3 和标准末端安装的用途；空载调试可暂缓末端的那一个，但自制末端仍须另外设计连接件。手册第 97 页可定位标准夹爪法兰用途。

其余大同步轮、`J1_rotation_shaft`、`J2_shaft` 在本仓库中有打印模型；不要仅因名称带 shaft 就额外采购钢轴。`Building instructions （装配说明）/custom_couplers.md` 标有 `STILL TODO`，不据此购买替代机加工法兰。

## 4. 轴承

来源：[BOM Bearings](../BOM%20%EF%BC%88%E7%89%A9%E6%96%99%E6%B8%85%E5%8D%95%EF%BC%89/BOM.md#bearings)；手册第 18、22、25、40、50、70、80、94、96 页。

| 采购项 | 规格 | BOM 数量 | 采购检查 |
| --- | --- | --- | --- |
| 推力滚针轴承组件 | AXK3552，BOM 写 35×52×4，要求上下垫片 | 1 套 | **滚针组件＋上、下两片垫片**；参考图也是三件。确认“4 mm”对应整套叠厚还是卖家某单件厚度，不能只买裸保持架 |
| 圆锥滚子轴承 | NSK HR32906J | 5 套 | J3/J4/J5；每套应含内圈滚子组件及匹配外圈，不能把内外圈各算一个轴承 |
| 圆锥滚子轴承 | NSK HR32907J | 4 套 | J1/J2；同上 |
| 张紧小轴承 | 内径×外径×厚度 3×8×4 mm | 20 个 | 按尺寸采购，不猜型号 |
| 张紧小轴承 | 内径×外径×厚度 3×10×4 mm | 20 个 | 与上项是两种不同外径，保留各 20 的原 BOM 参考量 |

手册第 18 页明确两种张紧轴承可按需要组合，**每处在一颗螺钉上成对安装**，还可加张紧点，因此各 20 并非精确净耗用。第 96 页写“8×4×8×3 ball bearing”，其排列与 BOM 的 3×8×4 有冲突；该页同时要求用 M3 螺钉，应先按 BOM 3 mm 内径规格准备，在装配该处时实物核对，不能据这一处笔误下单 4 mm 内径轴承。

## 5. 紧固件：照规格分袋，数量为官方采购参考

来源：[BOM Screws and Nuts](../BOM%20%EF%BC%88%E7%89%A9%E6%96%99%E6%B8%85%E5%8D%95%EF%BC%89/BOM.md#screws-and-nuts)。数量本身未逐颗还原为装机净数，买标准包装时取足量整包，保留余量。

| 规格 | 头型 / 标准 | BOM 数量 |
| --- | --- | --- |
| M4×10 | DIN 912 / ISO 4762 内六角圆柱头 | 20 颗 |
| M3×8 | **头高 2 mm 的低头款** | 10 颗 |
| M3×8 | DIN 912 / ISO 4762 普通圆柱头 | 50 颗 |
| M3×14 | DIN 912 / ISO 4762 | 30 颗 |
| M3 六角螺母 | DIN 934 / ISO 4032 | 10 颗 |
| M3×25 | DIN 912 / ISO 4762 | 10 颗 |
| M2×10 | DIN 912 / ISO 4762 | 10 颗 |
| M3×16 | DIN 912 / ISO 4762 | 10 颗 |
| M3×6 | 十字盘头 | 10 颗 |
| M3×12 | DIN 912 / ISO 4762 | 30 颗 |
| M3×35 | DIN 912 / ISO 4762 | 10 颗 |
| M4×16 | DIN 912 / ISO 4762 | 30 颗 |
| M4×14 | DIN 912 / ISO 4762 | 10 颗 |
| M4×50 | DIN 912 / ISO 4762 | 10 颗 |
| M3×15 | 原文 `Tapered screw head`，锥形头 | 2 颗 |
| M3 热熔铜螺母 | 长 6 mm；列于 BOM Electronics | 4 个 |

采购易错点：

- 两种 **M3×8 不合并**。低头款在手册第 92 页用于底盖，普通头不能保证空间匹配。
- M3×15 锥头在第 44 页用于张紧处；BOM 没写完整 DIN 标准和锥角，按孔型、参考图确认，不能自行认定成任意沉头标准。
- **补购候选：M3×20，至少 1 颗用于试装核对。** 手册第 80 页正文明确写其作为 J1 旋转限位，但该页清单栏又写 M3×25，BOM 只有 M3×25 而没有 M3×20。两者长度矛盾必须按当前 `main_base_blocker` / `J1_turret_rework_blocker` 实际配合确认，不可用过长螺钉直接替代。
- 第 52 页允许 M3×35 或 M3×38，BOM 给的是 M3×35；不要把两种各买一套并当成全部必需。
- 第 74 页写 `1×M3 ?` 且注明该步非必要，长度未定义，保留待核，不编造规格。
- M3×6 与 M4×14 等部分螺钉兼作归零触发件，头型和伸出量会改变归零位置（第 38、65 页）。
- 法兰、同步轮、减速器和风扇的随附紧定螺钉/安装螺钉，应逐包清点，缺件再补；主 BOM 未给所有随附螺钉的单独规格。

## 6. 电源、归零传感器、急停与线材

来源：[BOM Electronics](../BOM%20%EF%BC%88%E7%89%A9%E6%96%99%E6%B8%85%E5%8D%95%EF%BC%89/BOM.md#electronics)；手册第 9、16、19、21、31–32、38、42、54、66、80、85、88–92、99 页。

| 项目 | 原方案规格 | BOM 数量 | 自研主控下的处理 |
| --- | --- | --- | --- |
| 直流电源 | 24 V / 5 A，参考 Mean Well EDR-120-24 | 1 台 | 可先按参考机械方案准备；最后按所选驱动器、电机同时运行和夹爪耗电复核总功率。裸 DIN 电源另需外壳、交流输入和接地配套，BOM 未详列 |
| 机械限位开关 | ZW12-3 | 3 个 | J2/J3/J5；保留安装外形，主控输入电路、有效电平自定 |
| 电感传感器 1 | **Φ4 mm 光杆体**，NPN、NO；参考图示长 30 mm | 1 个 | J6；这里 4 mm 是外形直径，不能当成感应距离；型号和供电范围 BOM 未明列，下单确认 |
| 电感传感器 2 | GX-F8A | 1 个 | J4；参考图约 23×8×7.4 mm 的方形本体。输出方式、供电和线序按实际资料确认，不可随意换成圆柱传感器 |
| 电感传感器 3 | M5 螺纹，NPN、NO | 1 个 | J1；核螺纹、感应距离、供电和线序 |
| 急停按钮 | NC 常闭 | 1 个 | 保留急停功能；原参考图为 19 mm 外形，若保留打印外壳，应核开孔和深度；具体断电/驱动使能架构由自研设计确定 |
| 急停线缆密封接头 | PG7 | 1 个 | 配合打印急停盒和所选线径 |
| GX16 电源接头 | 2 pin，公母配套 | 1 对 | 若保留原壳体接口，需一整对而非单只；额定电流及极性核实 |
| 开关按钮 | 12 mm，原 BOM 标 3–6 V | 1 个 | 待自研电源开关逻辑确定；此 3–6 V 的含义（如指示灯额定电压）原文不清，不能直接接 24 V |
| 按钮线 | JST PH 2.0 mm，4 pin，200 mm | 1 条 | 原板接口用；手册第 88 页最终裁至约 80 mm；自研板接口未定前可暂缓 |
| 散热风扇 | Noctua NF-A4x20 5 V，40 mm，或同尺寸 5 V 风扇 | 1 个 | 如沿用原外壳，核 40 mm 安装面和厚度；自研板须有相应 5 V 电源，不能接 24 V |
| 电夹爪接口 | M8，母座，4 pin | 1 个 | 只在需要电夹爪接口时购买；原方案为 24 V、GND、CANH、CANL |
| XT30 母头 | 原板供电用 | 1 个 | 自研板是否沿用待定；BOM 没给另一侧配对件规格，按实际接口补齐 |

**传感器不等于 MCU 直接可接。** 官方接线页第 85 页将机械限位接到 24 V 与输入信号，电感传感器是电源/地/信号三线；自研主控需要依据真实输出方式设计电平转换/隔离及保护。六个归零传感器不是六只同型号开关。

线材在 BOM 中未完整列为独立采购项，按手册第 9 页先备如下长度（为布线准备长度，最终裁剪）：

| 线束 / 管路 | 手册准备量 | 换算和备注 |
| --- | --- | --- |
| 电机线 | 6 组×4 芯×1 m | 6 m 四芯线，或等效 24 m 单芯导线；先扣除电机随附可用线长 |
| 机械限位线 | 3 组×2 芯×1 m | 3 m 两芯线，或等效 6 m 单芯 |
| 电感传感器线 | 3 组×3 芯×1 m | 3 m 三芯线，或等效 9 m 单芯；先扣除传感器自带线长 |
| 电夹爪线（可选） | 4 芯×1 m，两组双绞线 | 原方案 CAN 需要双绞；供电线截面积另按夹爪电流确定 |
| 气管（可选） | 内部 2 根×1 m | BOM 采购量为 5 m，规格外径 4 mm / 内径 2.5 mm，余量可供外部连接 |
| 主电源/急停/按钮/风扇线 | BOM 未列完整长度 | 第 89 页给 GX16→XT30 连接线至少 110 mm；其他按布局实测，不编造总米数 |

电机及供电线线径、屏蔽、耐弯折等级，BOM 没给出；选定驱动器及布线后再确定。以上是芯数和长度核对，不能把 24 m 单芯再加 6 m 四芯当成两份需求。母座/公头、插壳、端子、线缆压接件须成套检查，主板侧连接器待自研板定型。

## 7. 官方板相关项：不作为本项目必买

| 原 BOM 项 | 原数量 | 当前处理 |
| --- | --- | --- |
| PAROL6 control board | 1 | **不采购**；用户自行画板、写固件 |
| TMC5160 驱动模块 | 6 | 待驱动方案确定；需要六轴驱动能力，但不等于现在必须买这款模块。若保留其驱动路线，再核接口、采样电阻、散热、电流定义和封装 |
| Thermal paste / cement | 2，原文未给单位 | 原注“控制板不带驱动时才需要”；自研方案依据散热结构选择，不能理解为必需两管 |
| ST-Link / 官方编程转接板 | 1 | 官方转接板不采购；若自研 MCU 选 STM32，再决定普通 ST-Link、SWD 接口和线序；换其他 MCU 则不照购 |
| USB B 数据线 | 1 | 官方板连接 PC 用；待自研板 USB/串口/网络接口确定 |
| 官方板配套按钮线、XT30、5 V 风扇 | 见上一节 | 随自研板和壳体布局复核，保留机械安装尺寸不等于沿用其电气接口 |

官方固件 `src/constants.h` 第 25–30 行的六路电流设置分别为 2000、2000、1900、1700、1700、965（驱动配置使用的数值）；它们是**官方固件配置值，不是电源额定电流总和，也不是新驱动器通用旋钮值**。自研硬件的峰值/RMS 电流定义、散热和保持电流必须单独确定。

## 8. 夹爪与气动件：按路线选，不必全买

来源：[BOM Electronics](../BOM%20%EF%BC%88%E7%89%A9%E6%96%99%E6%B8%85%E5%8D%95%EF%BC%89/BOM.md#electronics)、[Vacuum gripper](../BOM%20%EF%BC%88%E7%89%A9%E6%96%99%E6%B8%85%E5%8D%95%EF%BC%89/BOM.md#vacuum-gripper)；装配手册第 31–32、90、97–100 页。

| 路线 | 采购项 | 原 BOM 数量 | 备注 |
| --- | --- | --- | --- |
| 标准气动夹爪 | MHZ2-16D | 1 个 | 对应标准打印夹爪座 |
| 标准气动夹爪 | PC4-M5 接头 | 2 个 | 管外径 4 mm，M5 螺纹；确认夹爪是否随附，避免重复 |
| 气动布管 | PM 型 4 mm 穿板接头 | 4 个 | 手腕 2、底座 2；核安装螺母是否随附 |
| 气动布管 | 外径 4 / 内径 2.5 mm 气管 | 5 m | 原描述另写“1 meter”，应理解为卖家单位规格存在歧义；BOM 数量栏明确为总 5 m |
| 气动控制 | 5/2 电磁阀，24 V，适配 4 mm 管接头 | 1 个 | 阀口及所需接头是否包含需核；线圈需匹配自研板驱动和续流保护 |
| 真空吸盘 | Suction cup gripper | 1 个 | 尺寸/螺纹/吸力未列，不能直接当作已明确可下单规格 |
| 真空吸盘 | Vacuum generator | 1 个 | 气源驱动或其他类型、耗气/工作压力/接口未完整列出，待确认 |
| 真空吸盘 | 4→6 mm 转接头 | 1 个 | 随具体管路复核 |
| 电动夹爪 | 电动夹爪本体及其驱动、电源、线束 | 待选型 | 本仓库主 BOM 不是电夹爪完整采购表；SSG48/MSG/自制方案需各自 BOM，不能认为买个 M8 插头就齐了 |

气动方案还需压缩空气来源及相应调压/过滤和连接管路，主 BOM 未给完整规格与数量，应按夹爪及真空发生器实际要求补齐。**第一阶段可不装夹爪，先完成机械臂和六轴归零运动调试；不使用气动时暂不买整套气源、阀、管接头和气管。**

## 9. 打印件与耗材

仓库 `STL （三维打印模型）` 共 **45 个 STL 文件**，含替代件、不同夹爪座和小平台分体版本，**不是 45 件都打印一遍**。

| 分类 | 目录及模型文件数 | 处理 |
| --- | --- | --- |
| 主体底座 | `STL （三维打印模型）/BASE （底座）`，5 个模型 | 自研主板可能改变电子盒、盖板及接口位置，先核布局再打印相关件 |
| 肘部 | `STL （三维打印模型）/ELBOW （肘部）`，5 个模型 | 按手册装配 |
| 前臂 | `STL （三维打印模型）/FOREARM （前臂）`，5 个模型 | 按手册装配 |
| 肩部 | `STL （三维打印模型）/SHOULDER （肩部）`，8 个模型 | 使用当前 `rework` / `blocker` 版本，不能按旧名称漏打印限位相关件 |
| 上臂 | `STL （三维打印模型）/UPPER_ARM （上臂）`，9 个模型 | 整件 Upper_arm 与小平台版本二选一 |
| 手腕 | `STL （三维打印模型）/WRIST （腕部）`，1 个模型 | `wrist.STL` |
| 急停盒 | `STL （三维打印模型）/ESTOP （急停盒）`，2 个模型 | 需先匹配急停实物尺寸 |
| 夹爪及附件 | `STL （三维打印模型）/GRIPPER_ATTACHMENTS （夹爪连接件）`，5 个模型 | 标准气动座、水平/定制座、真空座和夹爪指，按选定末端选用 |
| 小平台替代 | `STL （三维打印模型）/SMALL_PRINT_BED （小尺寸打印平台）`，4 个模型 | 分体上臂 2 件替换整件上臂，分体 J1 件 2 件替换整件 J1 件；不叠加打印 |
| 铝型材辅助件 | `STL （三维打印模型）/UTILITY （辅助零件）`，1 个模型 | `connectors_4_alu_profiles.STL`，按底座固定方式选用 |

以上主体六类共 33 个模型文件；这是文件目录核对，不是经过网格连通体计数后的装机实体总数。底座安装板另有 STEP/PDF（`STL （三维打印模型）/mounting plates （安装板）`），主 BOM 未完整给工作台/型材/安装螺钉规格，选定固定方式后补采购。

打印材料按手册用 PETG。工作簿 `3D printed parts stats!E5:P46` 有部分质量与时间空白，且 `J1_turret` 在第 27、41 行有重复和 25%/45% 两种填充率，夹爪座和 J2 限位罩也有重复/旧名称；**不能把该表直接求和当成准确耗材总量或打印总时长**。有质量数字的单元格合计 1312.65 g，仅为不完整且含重复项的记录之和，不是完整净耗材。应对最终选定 STL 逐件切片，加入支撑、试打和返工量后决定耗材卷数。

可参考工作簿常见设置：0.2 mm 层高、3 圈外壁、顶部 6 层/底部 4 层；不同件填充差异较大，不能所有件统一照某一个百分比。`Wire_markings` 大多靠单元格底色标记，不能仅依赖抽出的文字；建议自己的线束另做清晰的关节编号标签。

装配手册第 12 页还要求：蓝色螺纹锁固剂、锂基润滑脂、绝缘胶带、焊锡、热缩管、线束材料、布基胶带。各备一份可用包装即可，原资料没有精确耗量；**这些是补充耗材，不在主 BOM 中逐项计数**。金属件螺钉用锁固剂的位置见第 10、63–64、94 页。

装配工具在第 11 页提到电动螺丝刀配合最后手拧/扭矩控制。实际至少需匹配螺钉的内六角/十字工具、焊接与剥线工具、卡尺、去支撑工具；已有工具无需重复采购。

### 仅小打印平台需要的额外采购

只在整件放不进平台时使用，来源为 BOM 最后一节及小平台改装手册第 4–5 页：

- 4×18 mm **实心圆柱定位销** 3 根，J1 分体件使用。
- 6×22 mm 实心圆柱定位销 4 根，上臂分体件使用。
- 慢固化双组分环氧胶 1 份，不用弹性卷销，也不以瞬干胶代替。
- 工具/耗材：4 mm、6 mm H7 铰刀；容量至少 12 mm 的铰杠/扳手；4–6 个夹具、120 目砂纸、异丙醇及清洁工具；第 18 页还需要 1.8 mm 钻头。已有的可复用。

## 10. 下单前仍要确认的事项

| 待确认项 | 为什么必须确认 | 当前动作 |
| --- | --- | --- |
| 长电机保持扭矩 65/76 N·cm 冲突 | BOM 与现行商品页不同 | 发型号和尺寸图给卖家，核电流、轴径/轴伸与减速器安装匹配 |
| J1 限位螺钉 M3×20 / M3×25 | 手册同页自相矛盾且 BOM 无 M3×20 | 准备补购 M3×20 试装，按当前打印件验证 |
| 第 96 页轴承排列歧义 | 文中 4×8×3 与 BOM 3×8×4 不一致 | 不按该笔误改下单规格；装配点实测 |
| AXK3552 上下垫片及叠厚 | 裸轴承和带垫片套装不同 | 卖家确认 1 套包含 3 部件及总厚 |
| M3×15 锥头、低头 M3×8 | 普通头型可能干涉 | 按孔型及实际头高验收 |
| 圆柱传感器与 GX-F8A | 外形、供电、输出和极性有区别 | 不用“3 个接近开关”笼统下单 |
| 自研板接口与驱动 | 关系到六轴驱动、电流、传感器输入、电源和连接器 | 单独产出自研电子 BOM；本清单不预定 MCU、驱动芯片或 PCB |
| 自研板壳体安装 | 原 Electronics_case 为官方板布局 | 可先打印机械主体，相关电子盒/盖板待布局后定 |
| 末端路线 | 气动夹爪、吸盘、电夹爪采购互不相同 | 先完成空载机械臂也可，不把三条路线同时采购 |
| 工作台固定与供电配套 | 主 BOM 未覆盖整个工作环境 | 按固定底座、电源类型和气源另补清单 |

建议采购顺序：先确认三种电机与两种减速器的尺寸配套，再采购机械传动与轴承、分规格螺钉及耗材；随后按已选定的主控接口采购传感器/接插件和板级器件；夹爪及气动系统最后按用途选购。

## 11. 按尺寸采购与成套减速电机（后续补核）

用户采购原则：**安装尺寸和接口优先，品牌不限；参考型号不等于限定品牌。** 替代时仍须满足对应减速比、扭矩、额定电流、回差和成套安装要求。

- 6台电机均为约42×42 mm安装面的NEMA17，但机身长度不同：J1/J2参考60 mm，J3/J4/J5参考40 mm，J6原BOM参考20 mm。
- 可考虑3套尺寸匹配的减速步进电机（J2 20:1、J3 20:1、J6 10:1）加3台裸电机（J1/J4/J5），避免重复采购。整套安装孔距、定位面、输出轴径/轴伸和总长必须对尺寸图。
- 现售17HS08-1004S：机身21.5 mm，电机轴Φ5 mm、轴伸20 mm；EG17-G10网页标输入适配轴长21.5–25 mm。存在配套尺寸疑问，尚未验证有效夹紧，J6组合先让卖家确认。
- 原参考中电机轴伸23 mm，长电机轴伸24 mm，轴径均Φ5 mm；这是现售原型号数据，不是任何42电机的统一尺寸。
- 32906参考内径30×外径47×总宽12 mm；32907参考35×55×14 mm。品牌可换，但应选成套、同结构且公差和倒角匹配的轴承。

来源：[小电机现售规格](https://www.omc-stepperonline.com/nema-17-bipolar-1-8deg-16ncm-22-6oz-in-1a-3-7v-42x42x20mm-4-wires-17hs08-1004s)、[10:1减速器](https://www.omc-stepperonline.com/eg-series-planetary-gearbox-gear-ratio-10-1-backlash-15-arc-min-for-nema-17-stepper-motor-eg17-g10)、[32906尺寸](https://www.nsk.com/ph-en/engineering/hr32906j-trbsr-md.html)、[32907尺寸](https://www.nsk.com/au-en/engineering/hr32907j-apn.html)。中、长电机链接见第2节。
