pieterseyale-eng/PAROL6-Desktop-robot-arm/Docs （项目文档）/PAROL6标准件备货表.xlsx

PAROL6 机械标准件备货清单（按官方BOM）
已在BOM基准量上增加常用备件余量；建议采购量自动合计。黄色待确认/可选项先确认版本再下单；请按规格分袋贴标签，并注明每包颗数和包数。
类别 | 品名 | 规格 | 头型/标准/关键要求 | BOM基准数量 | 建议加备 | 建议采购量 | 单位 | 给卖家的备注 | 来源/状态
紧固件 | 内六角圆柱头螺钉 | M4×10 | DIN 912 / ISO 4762 | 20 | 5 |  | 颗 | 按颗数交货；如整包请标每包颗数及包数 | 官方BOM
紧固件 | 低头内六角螺钉 | M3×8 | 头高 2 mm；低头款（非普通圆柱头） | 10 | 3 |  | 颗 | 请确认头高2 mm，不能替换为普通头 | 官方BOM；手册P92
紧固件 | 内六角圆柱头螺钉 | M3×8 | DIN 912 / ISO 4762 普通圆柱头 | 50 | 10 |  | 颗 | 与上一行低头款分开包装、分开报价 | 官方BOM
紧固件 | 内六角圆柱头螺钉 | M3×14 | DIN 912 / ISO 4762 | 30 | 5 |  | 颗 | 按颗数交货；如整包请标每包颗数及包数 | 官方BOM
紧固件 | 六角螺母 | M3 | DIN 934 / ISO 4032 | 10 | 3 |  | 颗 | 普通六角螺母；规格/标准请标明 | 官方BOM
紧固件 | 内六角圆柱头螺钉 | M3×25 | DIN 912 / ISO 4762 | 10 | 3 |  | 颗 | J1限位长度存在手册正文与清单矛盾，先按此BOM规格备货并勿擅自替换 | 官方BOM；手册P80有冲突
紧固件 | 内六角圆柱头螺钉 | M2×10 | DIN 912 / ISO 4762 | 10 | 3 |  | 颗 | 按颗数交货；如整包请标每包颗数及包数 | 官方BOM
紧固件 | 内六角圆柱头螺钉 | M3×16 | DIN 912 / ISO 4762 | 10 | 3 |  | 颗 | 按颗数交货；如整包请标每包颗数及包数 | 官方BOM
紧固件 | 十字盘头螺钉 | M3×6 | 十字盘头；BOM未进一步注明标准 | 10 | 3 |  | 颗 | 勿改为内六角；核对十字槽和头型 | 官方BOM
紧固件 | 内六角圆柱头螺钉 | M3×12 | DIN 912 / ISO 4762 | 30 | 5 |  | 颗 | 按颗数交货；如整包请标每包颗数及包数 | 官方BOM
紧固件 | 内六角圆柱头螺钉 | M3×35 | DIN 912 / ISO 4762 | 10 | 3 |  | 颗 | 装配手册另允许M3×38，但BOM采购规格为M3×35，不需两种都备 | 官方BOM；手册P52
紧固件 | 内六角圆柱头螺钉 | M4×16 | DIN 912 / ISO 4762 | 30 | 5 |  | 颗 | 按颗数交货；如整包请标每包颗数及包数 | 官方BOM
紧固件 | 内六角圆柱头螺钉 | M4×14 | DIN 912 / ISO 4762 | 10 | 3 |  | 颗 | 部分位置兼作归零触发件，请勿擅改长度/头型 | 官方BOM；手册P65
紧固件 | 内六角圆柱头螺钉 | M4×50 | DIN 912 / ISO 4762 | 10 | 2 |  | 颗 | 按颗数交货；如整包请标每包颗数及包数 | 官方BOM
紧固件 | 锥形头螺钉 | M3×15 | 原文仅写 Tapered screw head；锥角/头部尺寸待确认 | 2 | 0 |  | 颗 | 请先发头型照片/尺寸确认后再发货；不要自行按普通沉头代替 | 官方BOM；手册P44
热熔嵌件 | 黄铜热熔铜螺母 | M3，长6 mm | 外径/滚花型式按打印孔尺寸确认 | 4 | 2 |  | 个 | 请按3D打印热熔嵌件供货；下单前确认外径 | 官方BOM Electronics
待确认 | 内六角圆柱头螺钉 | M3×20 | DIN 912 / ISO 4762 候选，仅试装确认用 | 1 | 0 |  | 颗（候选） | 手册P80正文写M3×20，页内清单/BOM写M3×25；请先不要并入正式数量，建议单独报价/备1颗试装 | 手册与BOM冲突；非确定项
可选（分体打印才需要） | 实心圆柱定位销 | Ø4×18 mm | 不锈钢或淬硬钢；非弹性开口销 | 3 | 1 |  | 根 | 仅采用小平台J1分体方案时需要；整件打印不买 | BOM小平台替代方案
可选（分体打印才需要） | 实心圆柱定位销 | Ø6×22 mm | 不锈钢或淬硬钢；非弹性开口销 | 4 | 1 |  | 根 | 仅采用小平台分体上臂时需要；整件打印不买 | BOM小平台替代方案
