pieterseyale-eng/PAROL6-Desktop-robot-arm/BOM （物料清单）/BOM reference images （物料参考图片）/ZH_XH_cable_direction.png

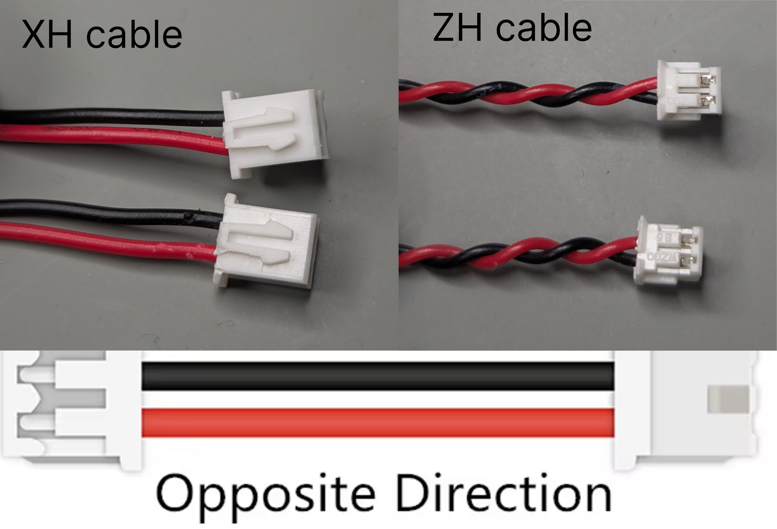
BOM （物料清单）/BOM reference images （物料参考图片）/ZH_XH_cable_direction.png
