pieterseyale-eng/PAROL6-Desktop-robot-arm/STL （三维打印模型）/BASE （底座）/main_base_blocker.STL

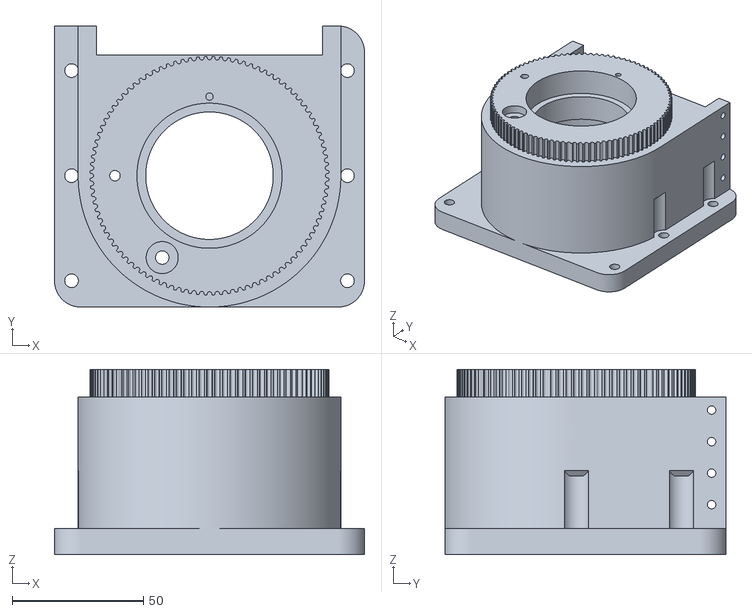
[picture p21: CAD file, 2026-11-05]
STL （三维打印模型）/BASE （底座）/main_base_blocker.STL
118.0 x 107.0 x 70.5
