pieterseyale-eng/PAROL6-Desktop-robot-arm/3D打印/临时联轴器试装/8mm法兰联轴器_试装.stl

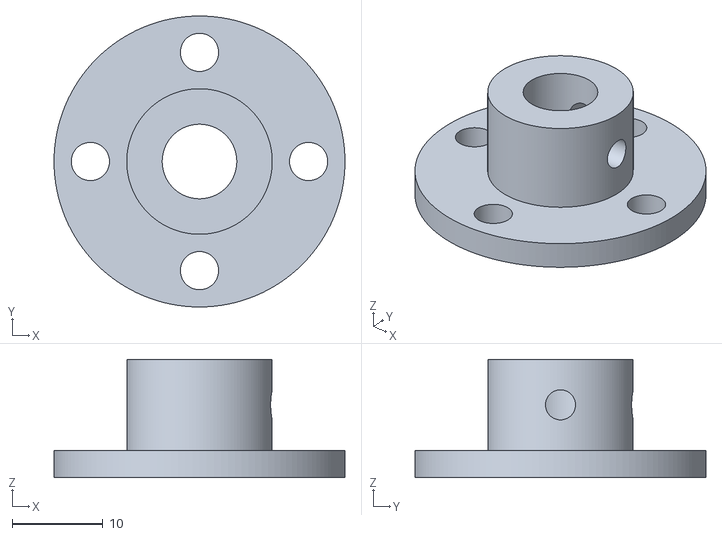
[picture p22: CAD file, 2026-11-11]
3D打印/临时联轴器试装/8mm法兰联轴器_试装.stl
32.0 x 32.0 x 13.0
