pieterseyale-eng/PAROL6-Desktop-robot-arm/3D打印/分锅STL/33/锅06_前臂与J5/J5_part_J6_plus30mm_v2.STL

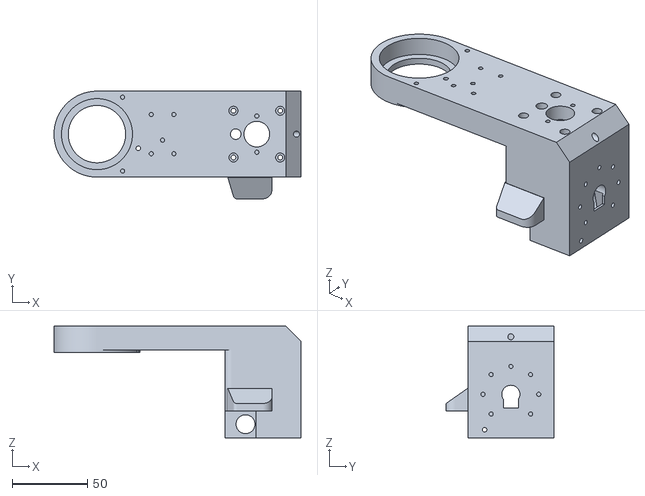
[picture p23: CAD file, 2026-11-06]
3D打印/分锅STL/33/锅06_前臂与J5/J5_part_J6_plus30mm_v2.STL
163.8 x 71.4 x 74.0
