pieterseyale-eng/PAROL6-Desktop-robot-arm/3D打印/分锅STL/锅01_底座主件/Upper_arm_wires_cover.3mf

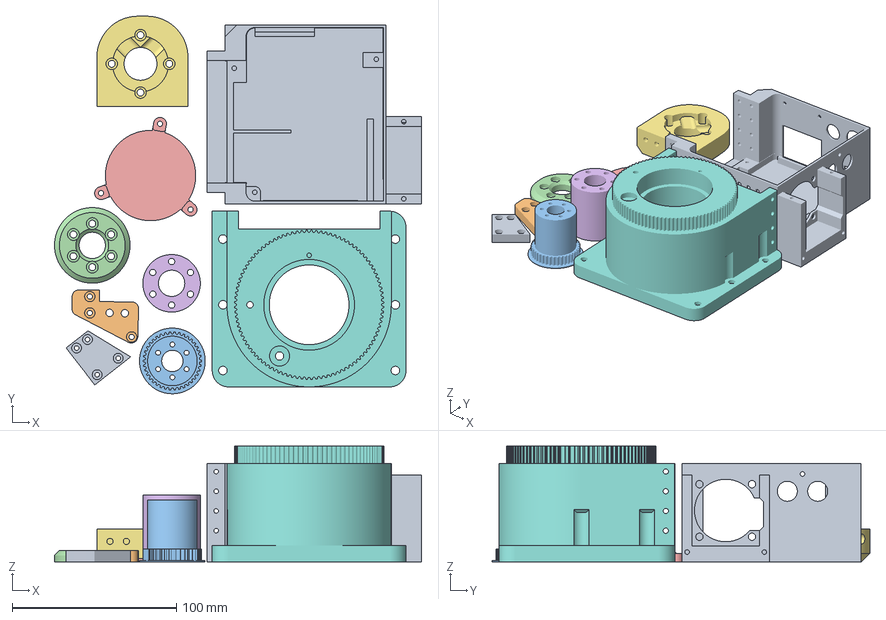
[picture p24: CAD file, 2026-11-07]
3D打印/分锅STL/锅01_底座主件/Upper_arm_wires_cover.3mf
223.4 x 229.9 x 70.5 mm
Upper_arm_wires_cover.STL
J3_limit_switch_cover.STL
38_pulley_J3.STL
J1_backplate.STL
J1_bottom_lid.STL
J1_rotation_shaft.STL
J1_turret_motor_holder.STL
main_base_blocker.STL
Electronics_case_v1_1.STL
