pieterseyale-eng/PAROL6-Desktop-robot-arm/3D打印/分锅STL/锅03_J1改装限位件_可选/111J1_turret_rework_blocker.3mf

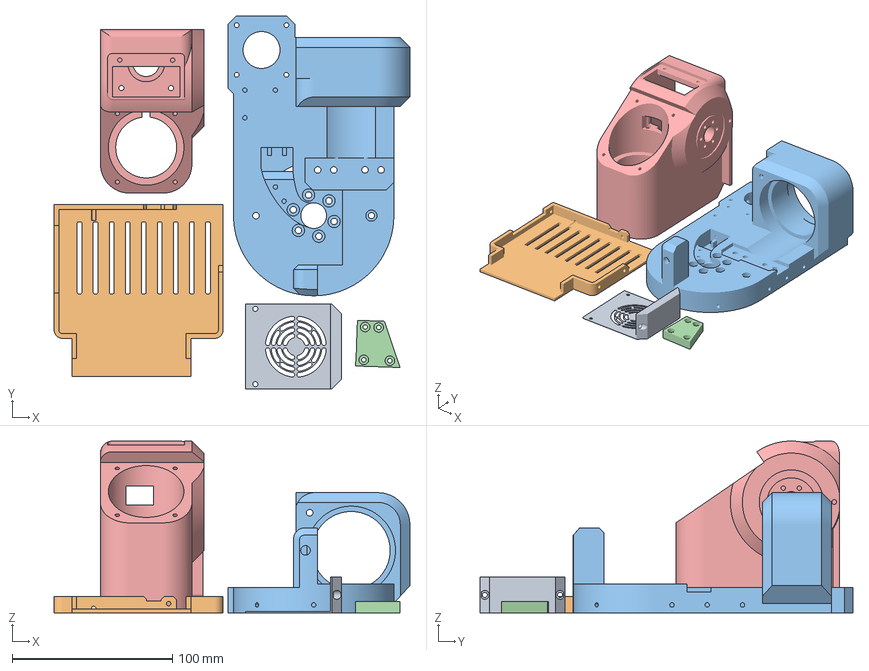
[picture p25: CAD file, 2026-11-13]
3D打印/分锅STL/锅03_J1改装限位件_可选/111J1_turret_rework_blocker.3mf
221.9 x 232.7 x 107.2 mm
fan_cover.STL
lid_electronics.STL
J1_turret_rework_blocker.STL
Upper_arm_wires_cover.STL
Elbow_part_motor_cavity_deeper30mm.STL
