pieterseyale-eng/PAROL6-Desktop-robot-arm/3D打印/分锅STL/锅05_肘部与J4/修改wrist_C_B_connector_relief_25x25.3mf

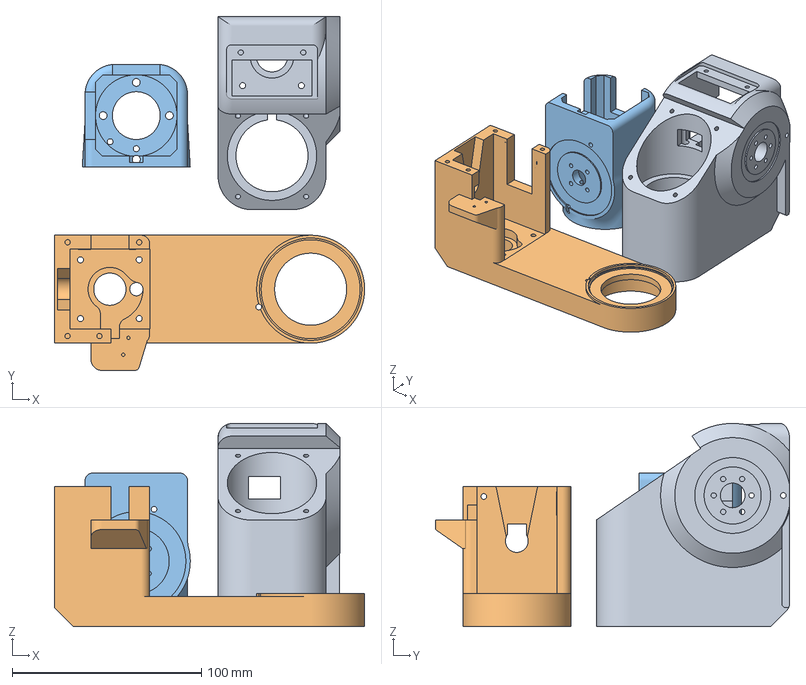
[picture p26: CAD file, 2026-11-11]
3D打印/分锅STL/锅05_肘部与J4/修改wrist_C_B_connector_relief_25x25.3mf
163.8 x 186.9 x 107.2 mm
Elbow_part_motor_cavity_deeper30mm_connector_relief_left_28_25.STL
J5_part_J6_plus30mm_v3_closed_holes_connector20.STL
wrist_C_B_connector_relief_25x25.STL
