pieterseyale-eng/PAROL6-Desktop-robot-arm/3D打印/分锅STL/锅06_前臂与J5/J5_part.STL

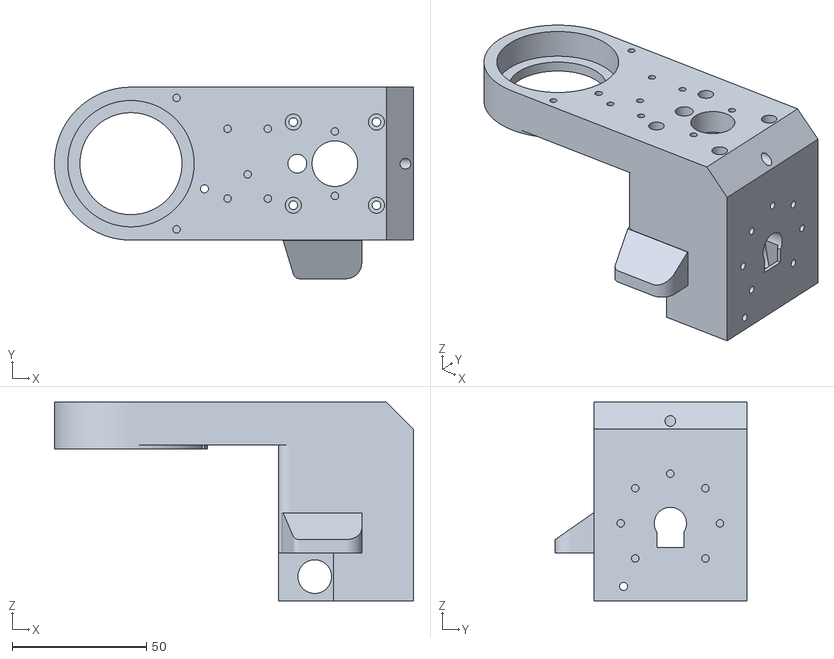
[picture p27: CAD file, 2026-11-05]
3D打印/分锅STL/锅06_前臂与J5/J5_part.STL
133.8 x 71.4 x 74.0
