pieterseyale-eng/PAROL6-Desktop-robot-arm/3D打印/分锅STL/锅07_腕部急停盒与J2/wrist_C_B_connector_relief_25x25.STL

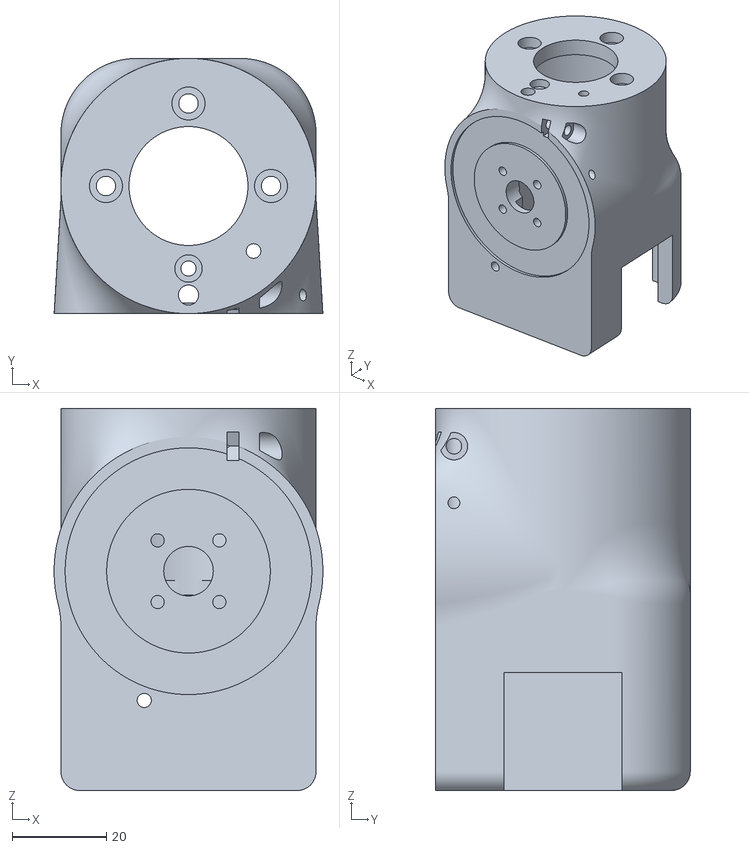
[picture p28: CAD file, 2026-11-11]
3D打印/分锅STL/锅07_腕部急停盒与J2/wrist_C_B_connector_relief_25x25.STL
57.0 x 54.1 x 81.0
