pieterseyale-eng/PAROL6-Desktop-robot-arm/3D打印/备份/Elbow_part_motor_cavity_deeper30mm_connector_relief_误开版.STL

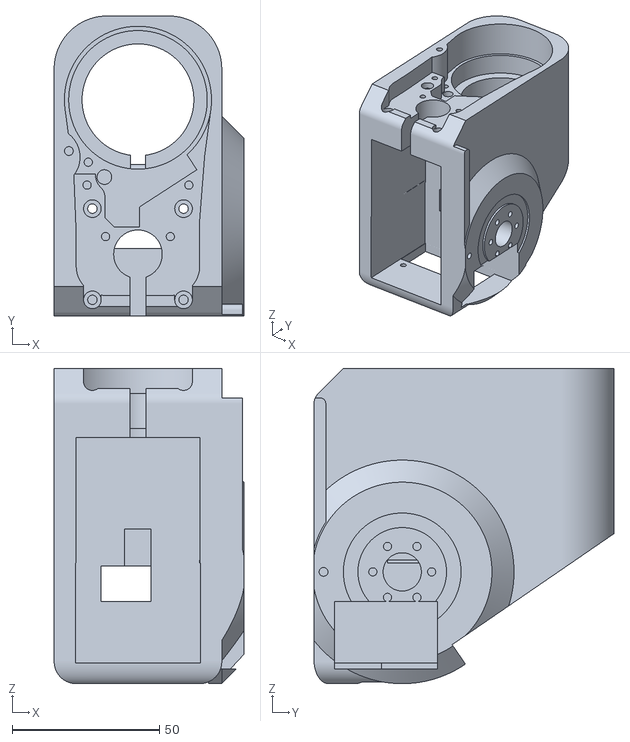
[picture p29: CAD file, 2026-11-11]
3D打印/备份/Elbow_part_motor_cavity_deeper30mm_connector_relief_误开版.STL
64.5 x 102.0 x 107.2
