pieterseyale-eng/PAROL6-Desktop-robot-arm/parol6_description （机器人模型说明）/parol6_description/meshes/arm/visual/shoulder_structure_visual.STL

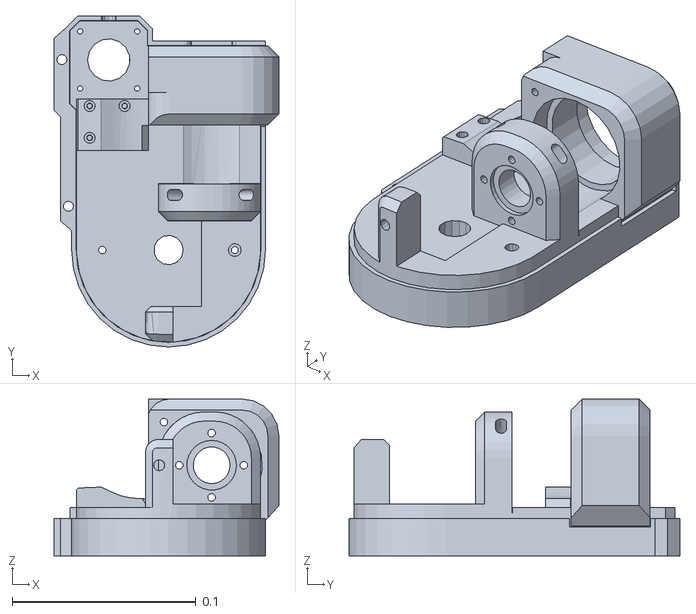
[picture p30: CAD file, 2026-11-06]
parol6_description （机器人模型说明）/parol6_description/meshes/arm/visual/shoulder_structure_visual.STL
0.122 x 0.18 x 0.0853
