pieterseyale-eng/PAROL6-Desktop-robot-arm/parol6_description （机器人模型说明）/parol6_description/meshes/contacts/msg_soft_tpu/left_01.STL

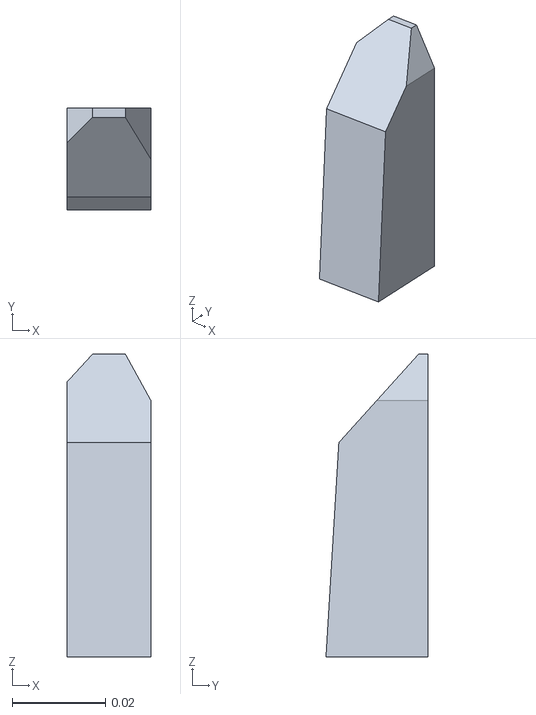
[picture p31: CAD file, 2026-11-06]
parol6_description （机器人模型说明）/parol6_description/meshes/contacts/msg_soft_tpu/left_01.STL
0.018 x 0.0219 x 0.065
