pieterseyale-eng/PAROL6-Desktop-robot-arm/parol6_description （机器人模型说明）/parol6_description/meshes/contacts/ssg48_fin_ray/right_04.STL

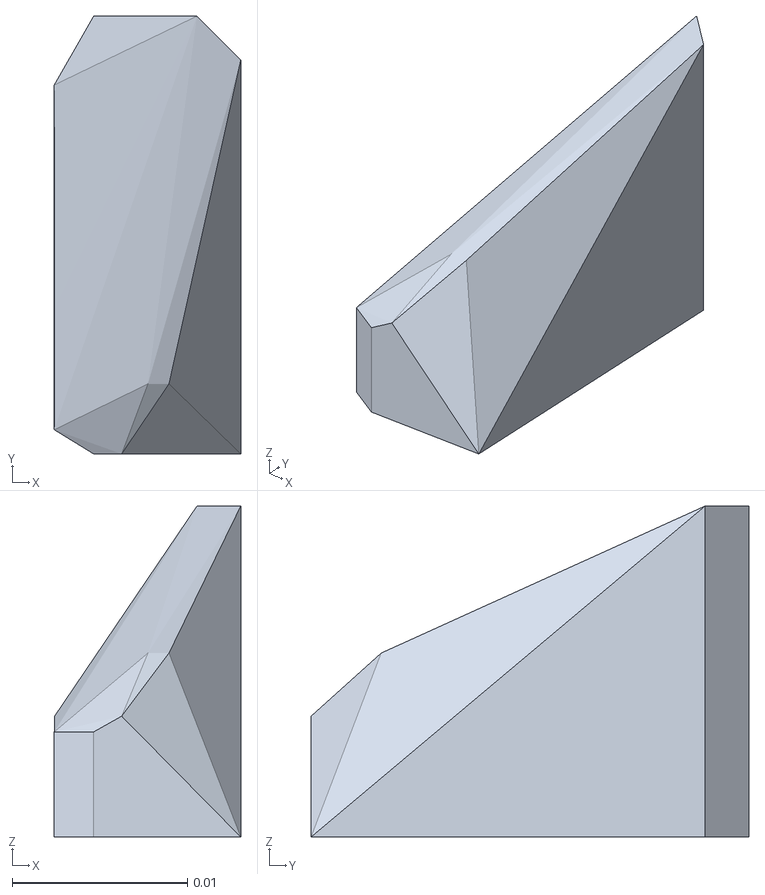
[picture p33: CAD file, 2026-11-06]
parol6_description （机器人模型说明）/parol6_description/meshes/contacts/ssg48_fin_ray/right_04.STL
0.0106 x 0.025 x 0.0189
