pieterseyale-eng/PAROL6-Desktop-robot-arm/parol6_description （机器人模型说明）/parol6_description/meshes/contacts/ssg48_solid/left_04.STL

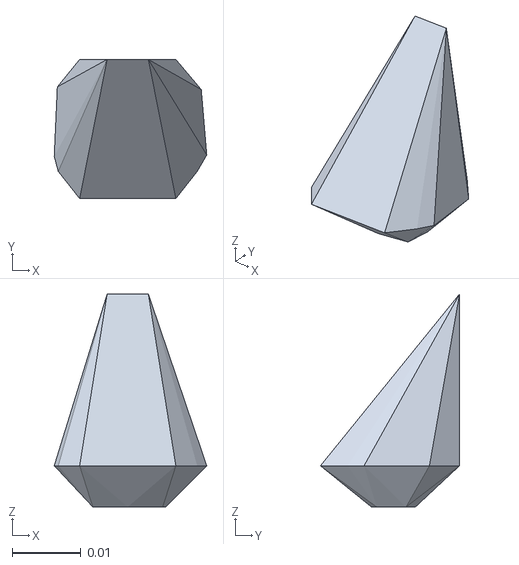
[picture p34: CAD file, 2026-11-06]
parol6_description （机器人模型说明）/parol6_description/meshes/contacts/ssg48_solid/left_04.STL
0.0222 x 0.0203 x 0.031
