pieterseyale-eng/PAROL6-Desktop-robot-arm/parol6_description （机器人模型说明）/parol6_description/meshes/msg/visual/msg_gripper_structure_visual.STL

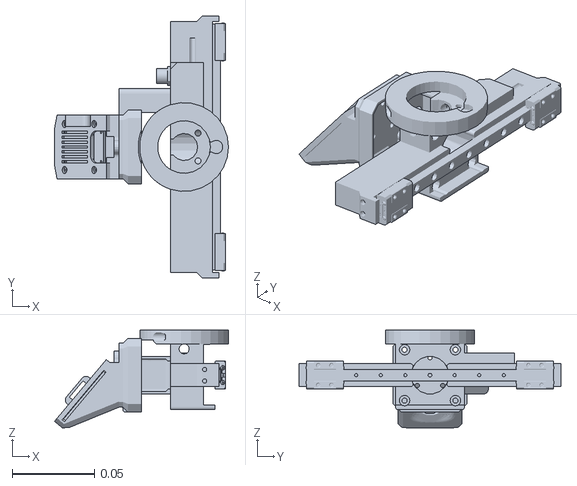
[picture p36: CAD file, 2026-11-06]
parol6_description （机器人模型说明）/parol6_description/meshes/msg/visual/msg_gripper_structure_visual.STL
0.106 x 0.159 x 0.0597
