pieterseyale-eng/PAROL6-Desktop-robot-arm/parol6_description （机器人模型说明）/parol6_description/meshes/pneumatic/right_finger_link_contact_04.STL

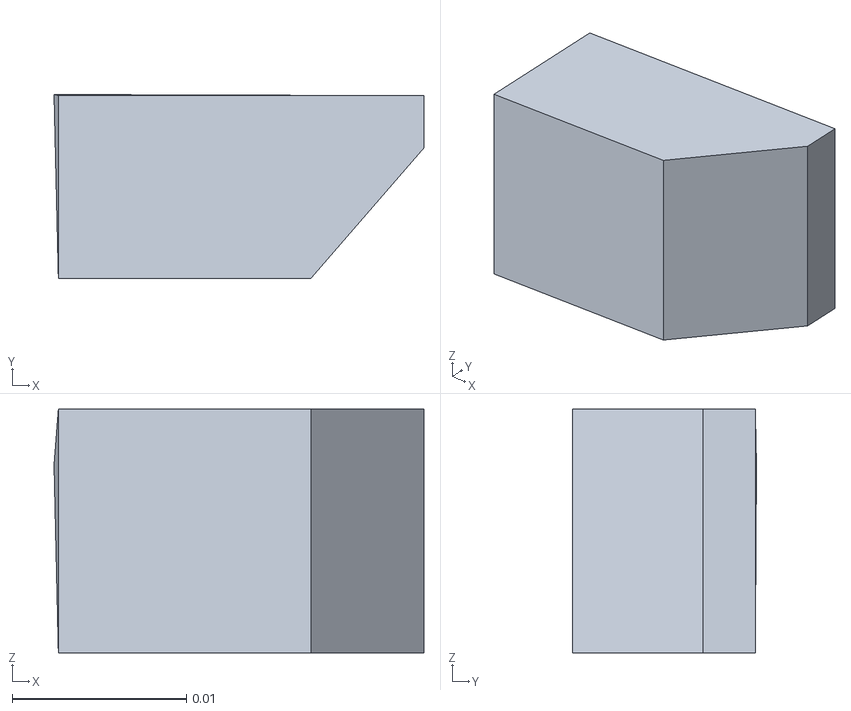
[picture p37: CAD file, 2026-11-06]
parol6_description （机器人模型说明）/parol6_description/meshes/pneumatic/right_finger_link_contact_04.STL
0.0213 x 0.0106 x 0.014
