pieterseyale-eng/PAROL6-Desktop-robot-arm/parol6_description （机器人模型说明）/parol6_description/meshes/ssg48/jaws/pinch/right.STL

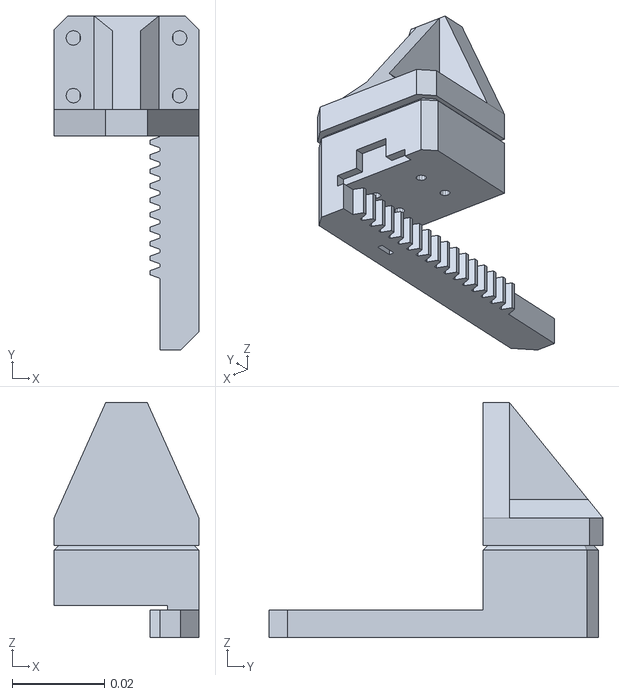
[picture p38: CAD file, 2026-11-06]
parol6_description （机器人模型说明）/parol6_description/meshes/ssg48/jaws/pinch/right.STL
0.0314 x 0.0723 x 0.0509
