pieterseyale-eng/PAROL6-Desktop-robot-arm/STL （三维打印模型）/ELBOW （肘部）/Elbow_part_motor_cavity_deeper30mm_connector_relief_left_28_25.STL

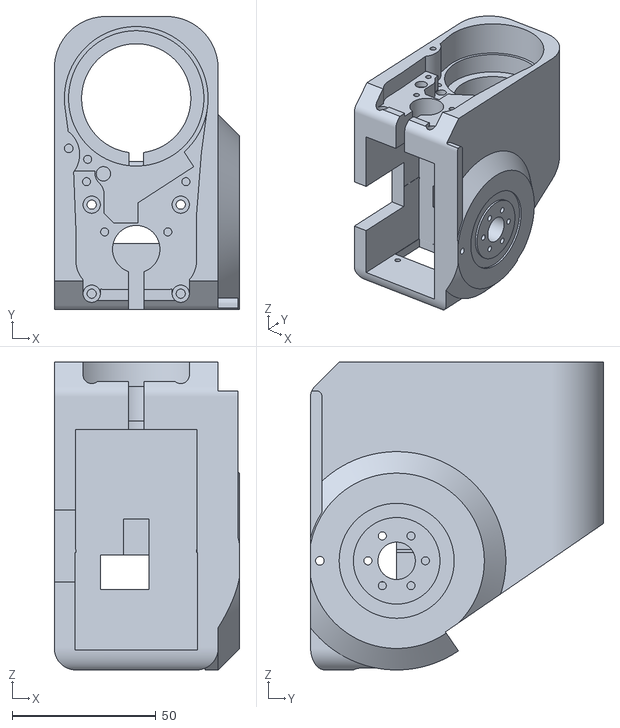
[picture p39: CAD file, 2026-11-11]
STL （三维打印模型）/ELBOW （肘部）/Elbow_part_motor_cavity_deeper30mm_connector_relief_left_28_25.STL
64.5 x 102.0 x 107.2
