pieterseyale-eng/PAROL6-Desktop-robot-arm/STL （三维打印模型）/FOREARM （前臂）/J5_part_J6_plus30mm_v3_closed_holes_connector20.STL

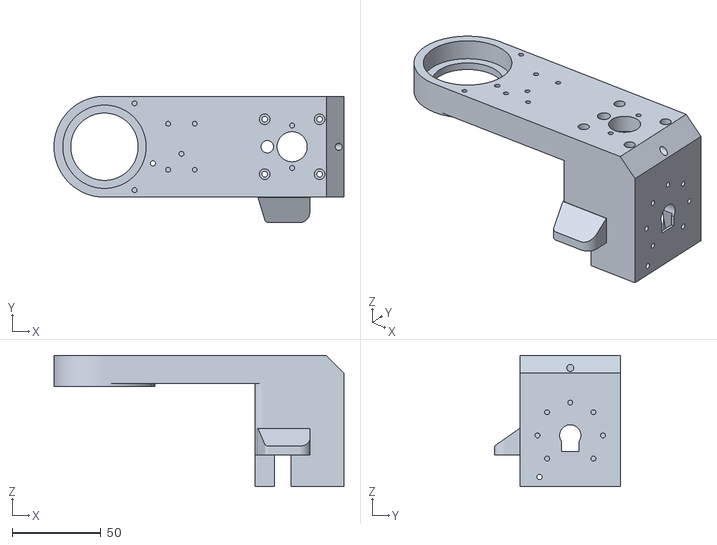
[picture p40: CAD file, 2026-11-11]
STL （三维打印模型）/FOREARM （前臂）/J5_part_J6_plus30mm_v3_closed_holes_connector20.STL
163.8 x 71.4 x 74.0
