pieterseyale-eng/PAROL6-Desktop-robot-arm/STL （三维打印模型）/SHOULDER （肩部）/J1_turret_rework_blocker.STL

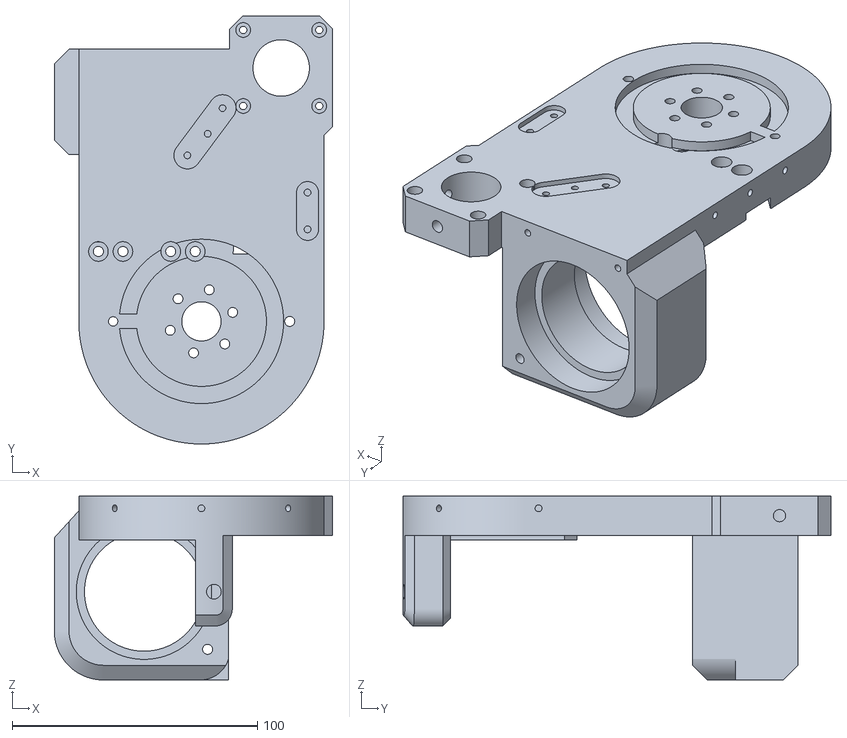
[picture p41: CAD file, 2026-11-05]
STL （三维打印模型）/SHOULDER （肩部）/J1_turret_rework_blocker.STL
113.5 x 174.5 x 75.0
