pieterseyale-eng/PAROL6-Desktop-robot-arm/STL （三维打印模型）/UPPER_ARM （上臂）/Upper_arm.STL

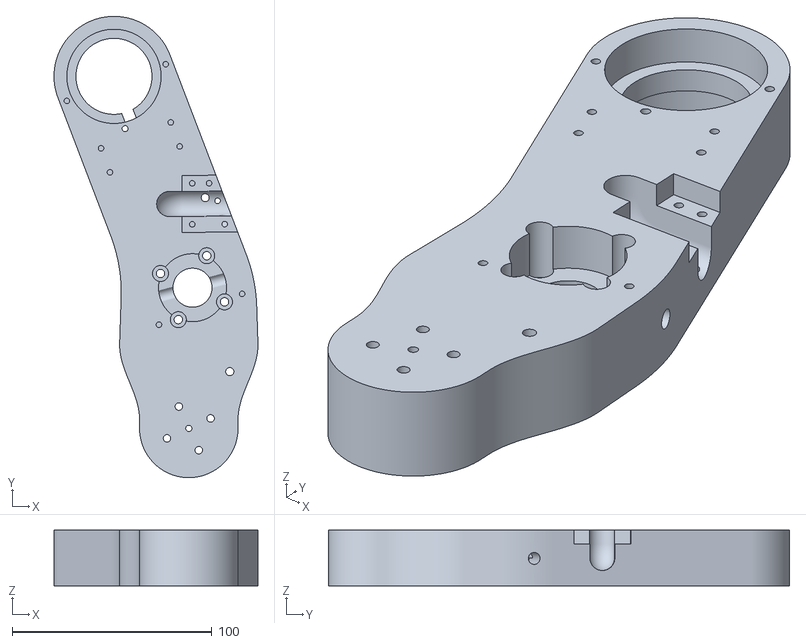
[picture p42: CAD file, 2026-11-05]
STL （三维打印模型）/UPPER_ARM （上臂）/Upper_arm.STL
102.0 x 230.7 x 28.0
