pieterseyale-eng/PAROL6-Desktop-robot-arm/3D打印/分锅STL/锅01_底座主件/fan_cover.STL

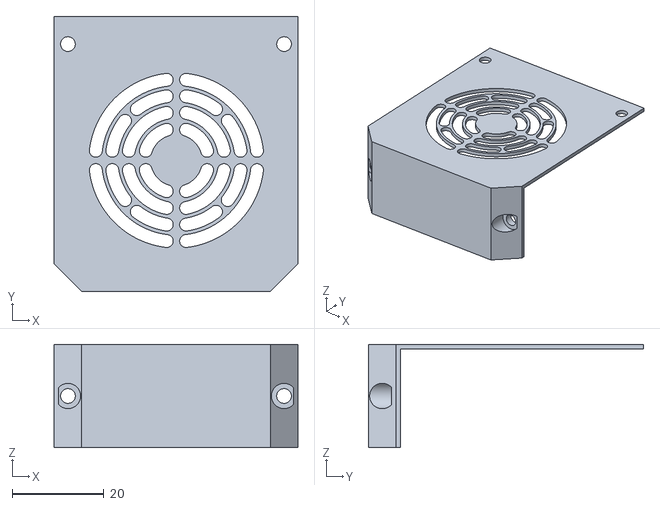
[picture p43: CAD file, 2026-11-05]
3D打印/分锅STL/锅01_底座主件/fan_cover.STL
53.0 x 59.8 x 22.5
