pieterseyale-eng/PAROL6-Desktop-robot-arm/3D打印/分锅STL/锅05_肘部与J4/一大堆HTD3_48_J5_pulley.3mf

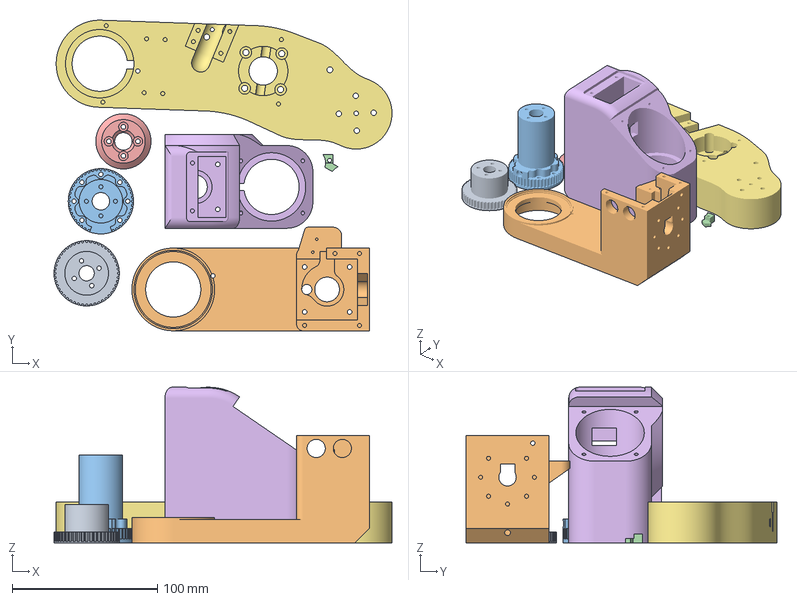
[picture p44: CAD file, 2026-11-07]
3D打印/分锅STL/锅05_肘部与J4/一大堆HTD3_48_J5_pulley.3mf
232.9 x 214.0 x 107.2 mm
HTD3_48_J5_pulley.STL
J5_part_J6_plus30mm_v2.STL
J4_output_pulley.STL
J4_limiter.STL
J4_bearing_backplate.STL
Elbow_part.STL
Upper_arm.STL
