pieterseyale-eng/PAROL6-Desktop-robot-arm/3D打印/分锅STL/锅06_前臂与J5/HTD3_48_J5_pulley.STL

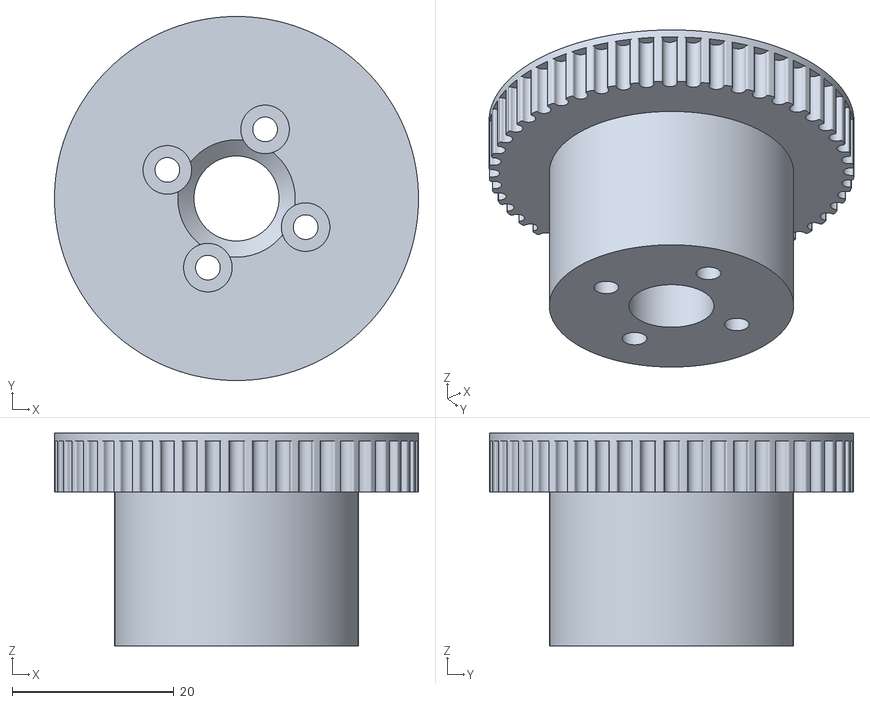
[picture p45: CAD file, 2026-11-05]
3D打印/分锅STL/锅06_前臂与J5/HTD3_48_J5_pulley.STL
45.0 x 45.0 x 26.3
