pieterseyale-eng/PAROL6-Desktop-robot-arm/3D打印/分锅STL/锅07_腕部急停盒与J2/这一锅打印07.3mf

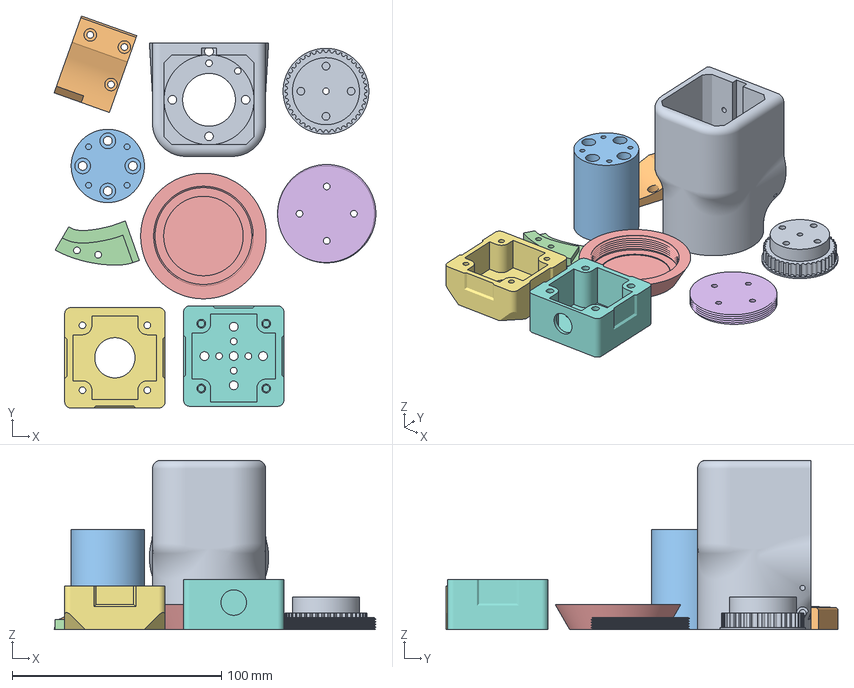
[picture p46: CAD file, 2026-11-06]
3D打印/分锅STL/锅07_腕部急停盒与J2/这一锅打印07.3mf
153.8 x 187.3 x 81.0 mm
wrist.STL
J2_stopper_block.STL
J2_shaft.STL
J2_limit_switch_cover.STL
J2_cover.STL
J2_bearing_backplate.STL
ESTOP_TOP.STL
ESTOP_BOTTOM.STL
42_pulley.STL
