pieterseyale-eng/PAROL6-Desktop-robot-arm/parol6_description （机器人模型说明）/parol6_description/meshes/arm/visual/j1_actuator_visual.STL

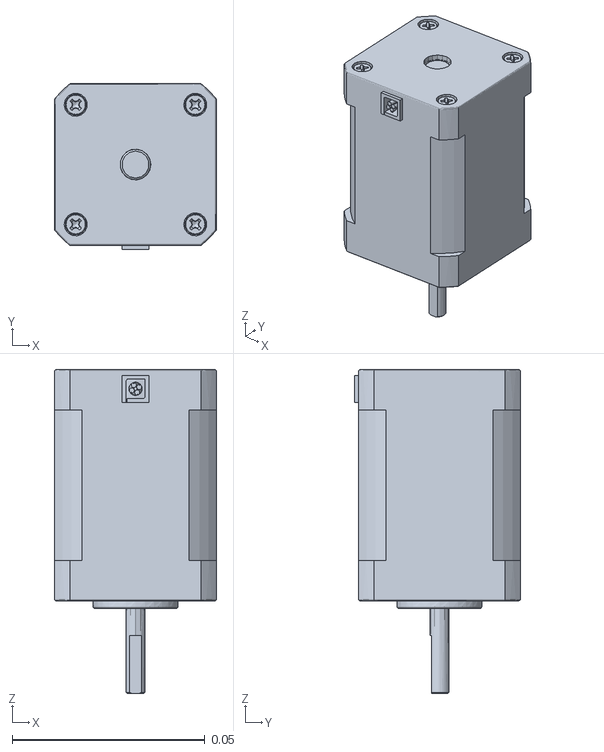
[picture p47: CAD file, 2026-11-06]
parol6_description （机器人模型说明）/parol6_description/meshes/arm/visual/j1_actuator_visual.STL
0.042 x 0.043 x 0.084
