pieterseyale-eng/PAROL6-Desktop-robot-arm/parol6_description （机器人模型说明）/parol6_description/meshes/contacts/msg_solid/left_03.STL

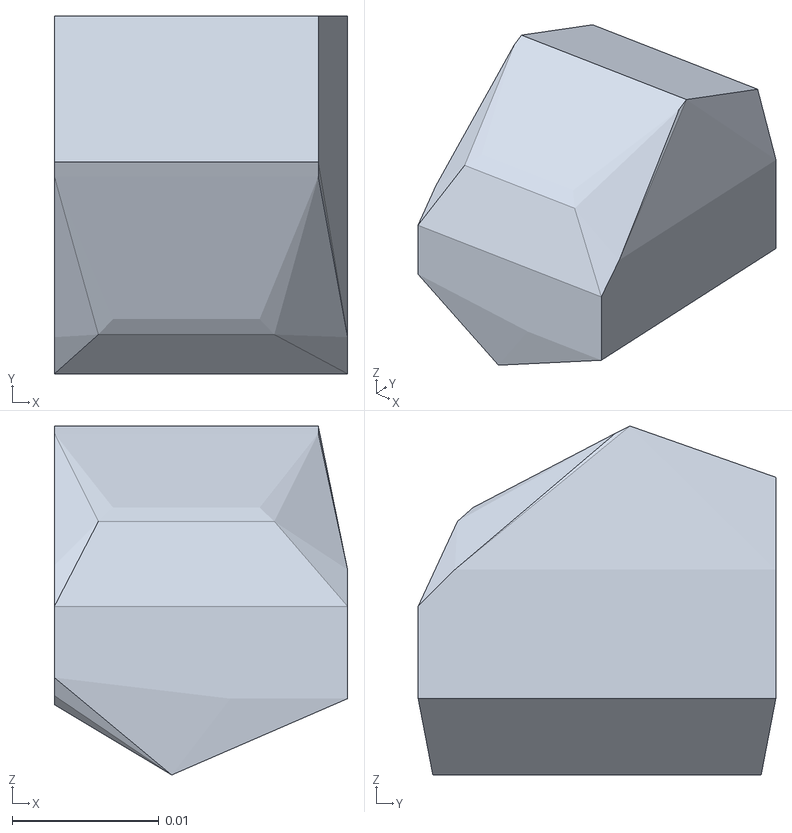
[picture p49: CAD file, 2026-11-06]
parol6_description （机器人模型说明）/parol6_description/meshes/contacts/msg_solid/left_03.STL
0.02 x 0.0244 x 0.0238
