pieterseyale-eng/PAROL6-Desktop-robot-arm/parol6_description （机器人模型说明）/parol6_description/meshes/contacts/ssg48_solid/left_01.STL

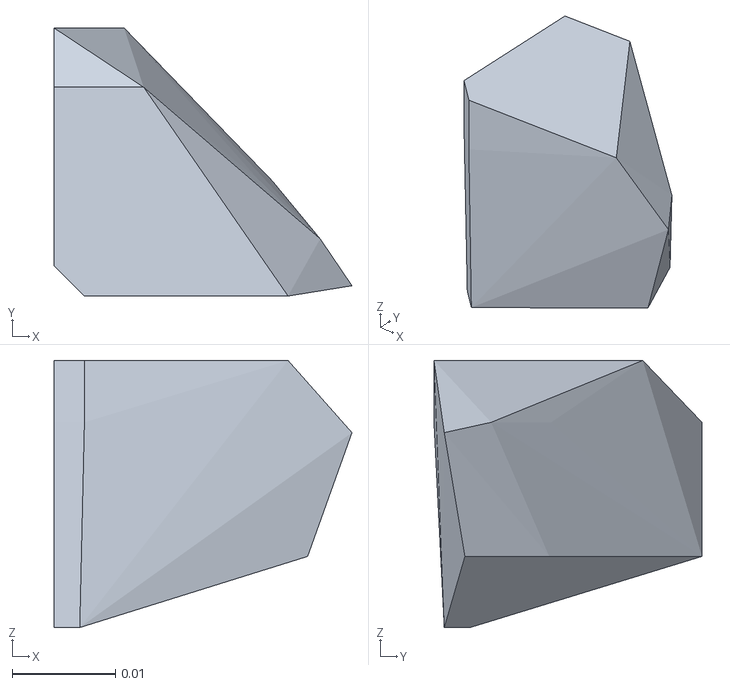
[picture p51: CAD file, 2026-11-06]
parol6_description （机器人模型说明）/parol6_description/meshes/contacts/ssg48_solid/left_01.STL
0.0289 x 0.026 x 0.0259
