pieterseyale-eng/PAROL6-Desktop-robot-arm/parol6_description （机器人模型说明）/parol6_description/meshes/msg/visual/msg_camera_lens_visual.STL

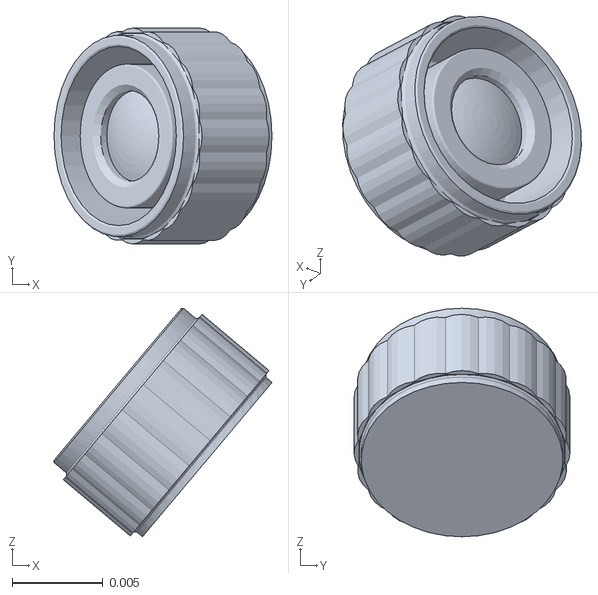
[picture p53: CAD file, 2026-11-06]
parol6_description （机器人模型说明）/parol6_description/meshes/msg/visual/msg_camera_lens_visual.STL
0.012 x 0.0119 x 0.0126
