pieterseyale-eng/PAROL6-Desktop-robot-arm/STL （三维打印模型）/BASE （底座）/Electronics_case_v1_1.STL

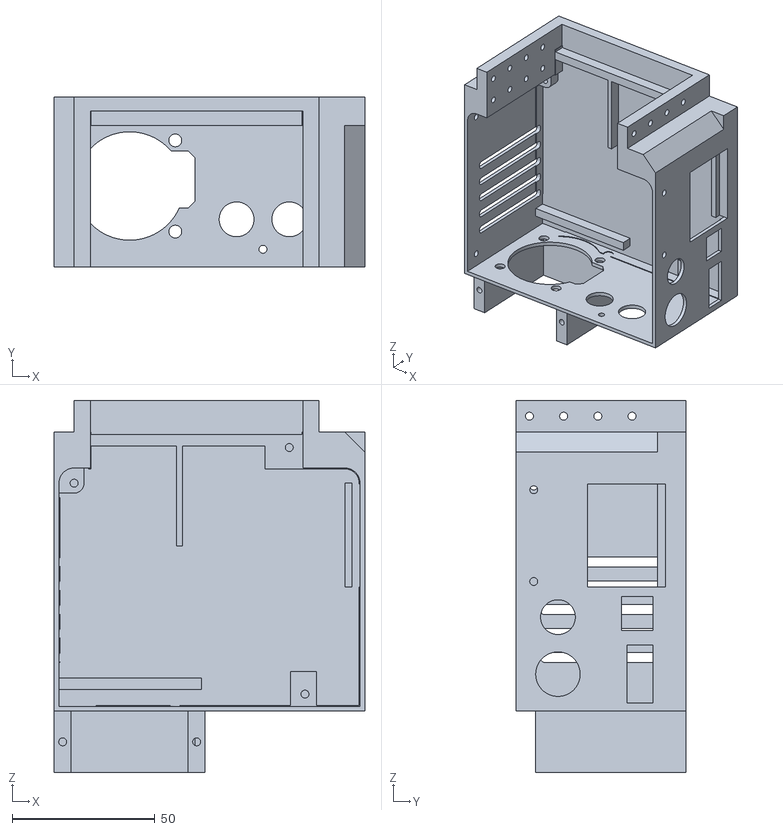
[picture p55: CAD file, 2026-11-05]
STL （三维打印模型）/BASE （底座）/Electronics_case_v1_1.STL
109.0 x 59.8 x 130.5
