pieterseyale-eng/PAROL6-Desktop-robot-arm/STL （三维打印模型）/FOREARM （前臂）/J5_belt_lid.STL

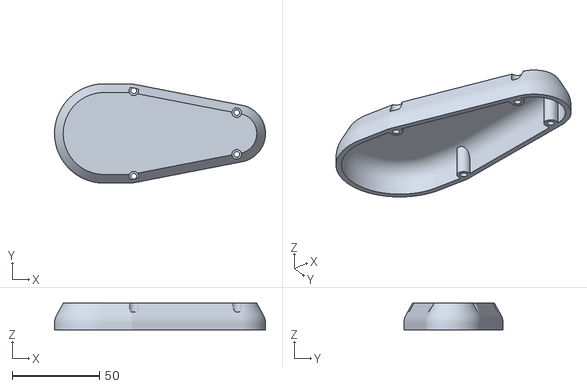
[picture p56: CAD file, 2026-11-05]
STL （三维打印模型）/FOREARM （前臂）/J5_belt_lid.STL
121.0 x 57.0 x 15.3
