pieterseyale-eng/PAROL6-Desktop-robot-arm/parol6_description （机器人模型说明）/parol6_description/meshes/arm/visual/upper_arm_structure_visual.STL

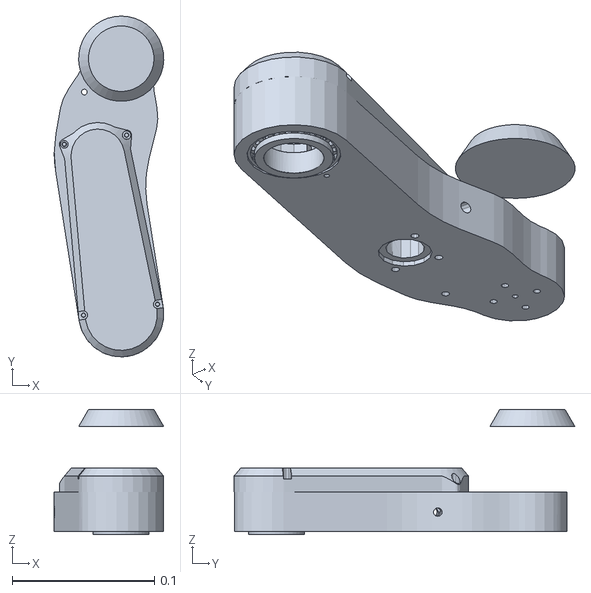
[picture p57: CAD file, 2026-11-06]
parol6_description （机器人模型说明）/parol6_description/meshes/arm/visual/upper_arm_structure_visual.STL
0.0771 x 0.24 x 0.088
