pieterseyale-eng/PAROL6-Desktop-robot-arm/parol6_description （机器人模型说明）/parol6_description/meshes/contacts/msg_soft_tpu/left_05.STL

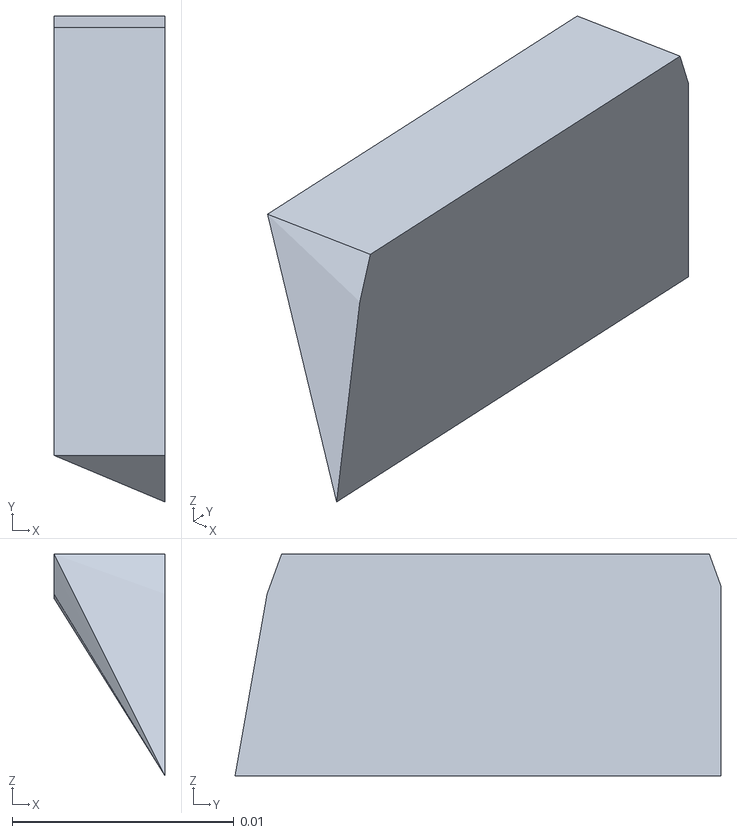
[picture p58: CAD file, 2026-11-06]
parol6_description （机器人模型说明）/parol6_description/meshes/contacts/msg_soft_tpu/left_05.STL
0.005 x 0.0219 x 0.01
