pieterseyale-eng/PAROL6-Desktop-robot-arm/parol6_description （机器人模型说明）/parol6_description/meshes/contacts/ssg48_fin_ray/right_05.STL

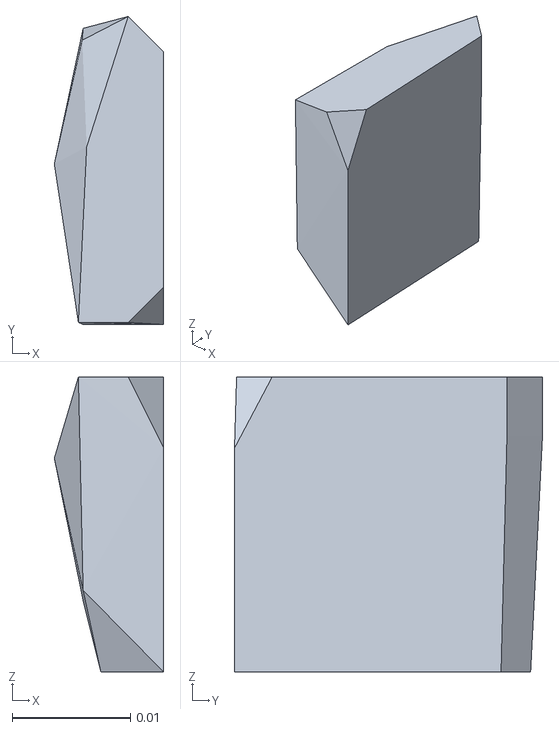
[picture p60: CAD file, 2026-11-06]
parol6_description （机器人模型说明）/parol6_description/meshes/contacts/ssg48_fin_ray/right_05.STL
0.00923 x 0.026 x 0.0249
