pieterseyale-eng/PAROL6-Desktop-robot-arm/parol6_description （机器人模型说明）/parol6_description/meshes/msg/jaws/tpu_glue/left_carriage.STL

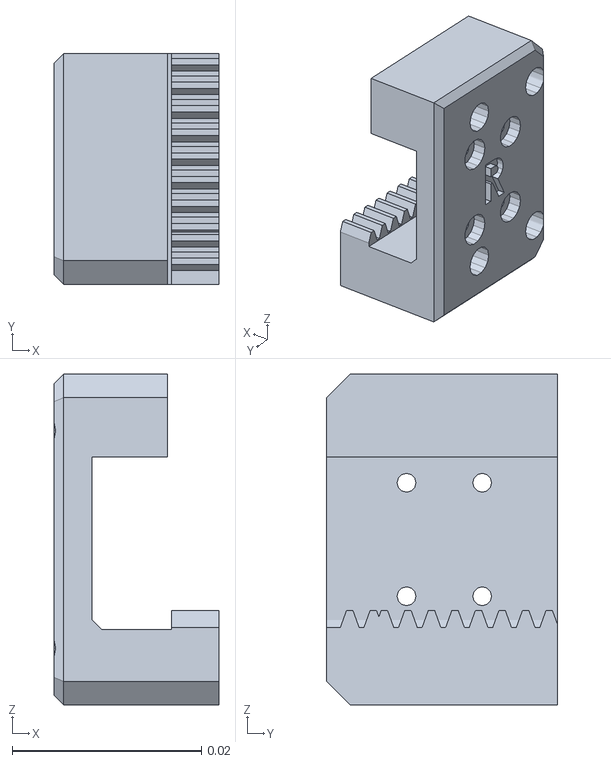
[picture p62: CAD file, 2026-11-06]
parol6_description （机器人模型说明）/parol6_description/meshes/msg/jaws/tpu_glue/left_carriage.STL
0.0174 x 0.0244 x 0.035
