pieterseyale-eng/PAROL6-Desktop-robot-arm/parol6_description （机器人模型说明）/parol6_description/meshes/msg/visual/msg_gripper_motor_visual.STL

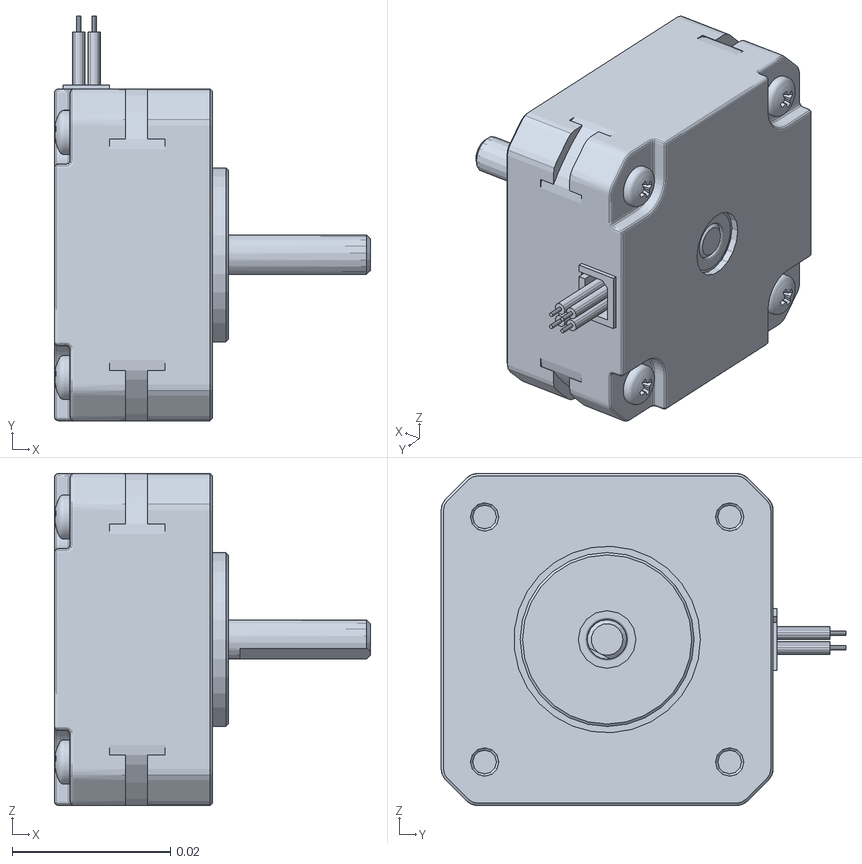
[picture p63: CAD file, 2026-11-06]
parol6_description （机器人模型说明）/parol6_description/meshes/msg/visual/msg_gripper_motor_visual.STL
0.04 x 0.0512 x 0.042
