pieterseyale-eng/PAROL6-Desktop-robot-arm/STL （三维打印模型）/FOREARM （前臂）/J4_output_pulley.STL

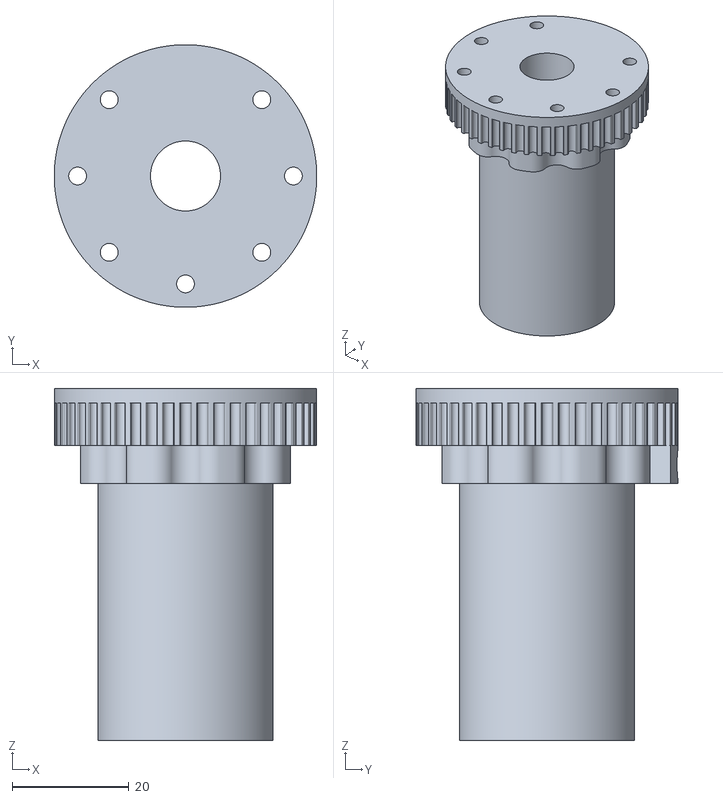
[picture p65: CAD file, 2026-11-05]
STL （三维打印模型）/FOREARM （前臂）/J4_output_pulley.STL
45.0 x 45.0 x 60.3
