pieterseyale-eng/PAROL6-Desktop-robot-arm/parol6_description （机器人模型说明）/parol6_description/meshes/arm/visual/j2_actuator_visual.STL

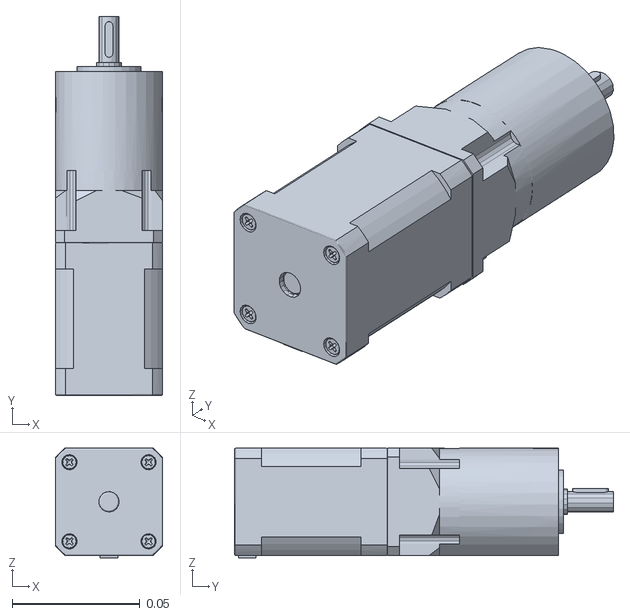
[picture p66: CAD file, 2026-11-06]
parol6_description （机器人模型说明）/parol6_description/meshes/arm/visual/j2_actuator_visual.STL
0.042 x 0.149 x 0.043
