pieterseyale-eng/PAROL6-Desktop-robot-arm/parol6_description （机器人模型说明）/parol6_description/meshes/contacts/msg_soft_tpu/right_03.STL

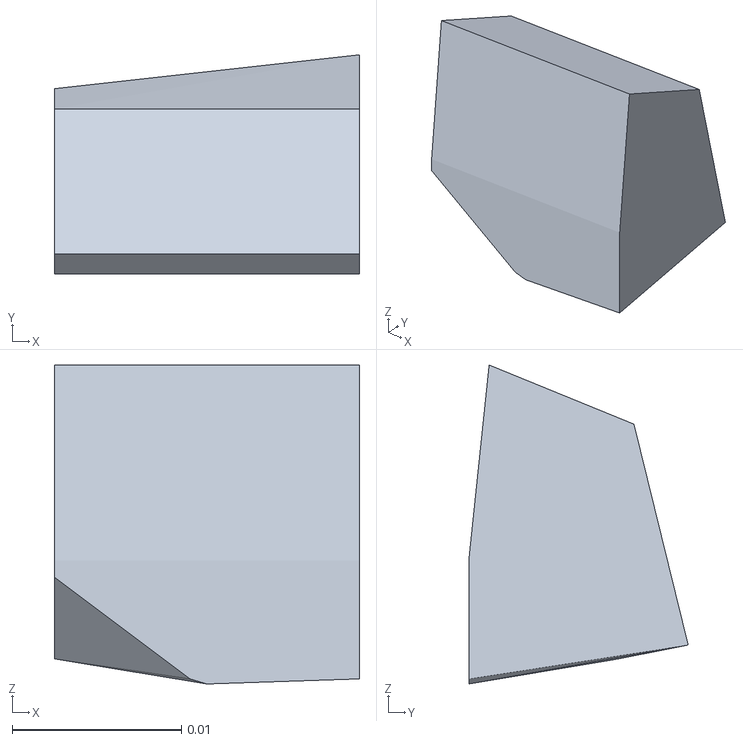
[picture p67: CAD file, 2026-11-06]
parol6_description （机器人模型说明）/parol6_description/meshes/contacts/msg_soft_tpu/right_03.STL
0.018 x 0.0129 x 0.0188
