pieterseyale-eng/PAROL6-Desktop-robot-arm/parol6_description （机器人模型说明）/parol6_description/meshes/pneumatic/pneumatic_gripper_link_contact_04.STL

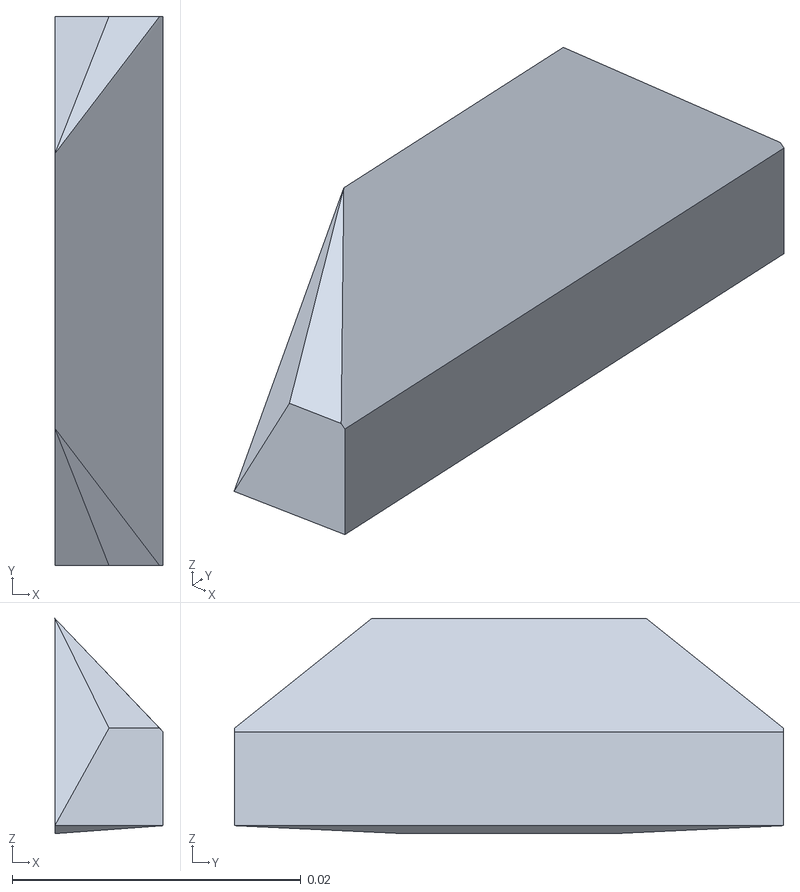
[picture p70: CAD file, 2026-11-06]
parol6_description （机器人模型说明）/parol6_description/meshes/pneumatic/pneumatic_gripper_link_contact_04.STL
0.0075 x 0.038 x 0.0149
