pieterseyale-eng/PAROL6-Desktop-robot-arm/parol6_description （机器人模型说明）/parol6_description/meshes/pneumatic/pneumatic_gripper_link_contact_00.STL

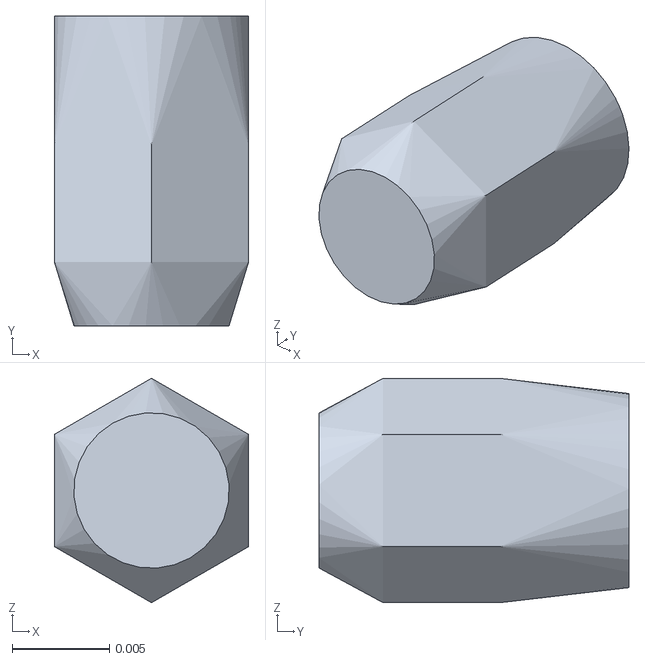
[picture p74: CAD file, 2026-11-06]
parol6_description （机器人模型说明）/parol6_description/meshes/pneumatic/pneumatic_gripper_link_contact_00.STL
0.01 x 0.0159 x 0.0115
