pieterseyale-eng/PAROL6-Desktop-robot-arm/parol6_description （机器人模型说明）/parol6_description/meshes/contacts/ssg48_fin_ray/right_01.STL

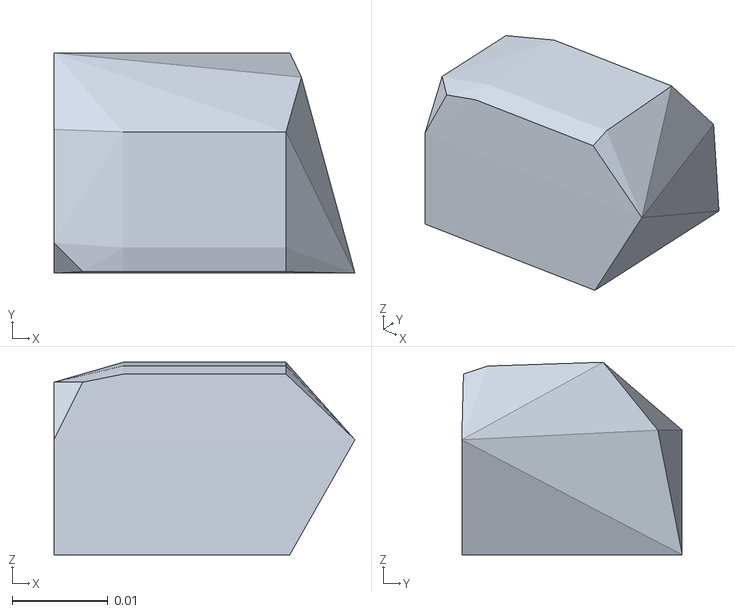
[picture p77: CAD file, 2026-11-06]
parol6_description （机器人模型说明）/parol6_description/meshes/contacts/ssg48_fin_ray/right_01.STL
0.0314 x 0.023 x 0.0201
