pieterseyale-eng/PAROL6-Desktop-robot-arm/parol6_description （机器人模型说明）/parol6_description/meshes/pneumatic/left_finger_link_contact_02.STL

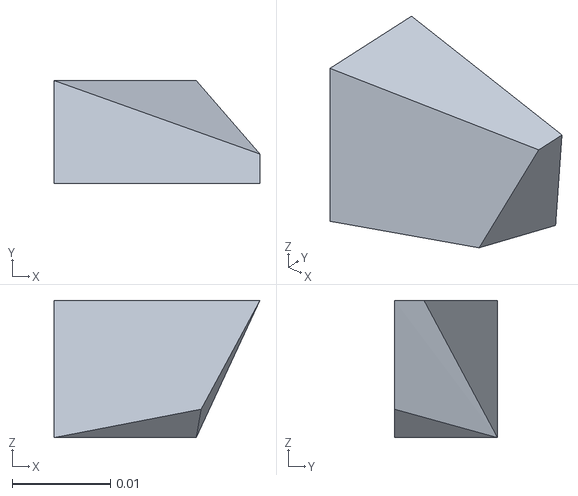
[picture p79: CAD file, 2026-11-06]
parol6_description （机器人模型说明）/parol6_description/meshes/pneumatic/left_finger_link_contact_02.STL
0.021 x 0.0105 x 0.014
