pieterseyale-eng/PAROL6-Desktop-robot-arm/parol6_description （机器人模型说明）/parol6_description/meshes/pneumatic/left_finger_link_contact_00.STL

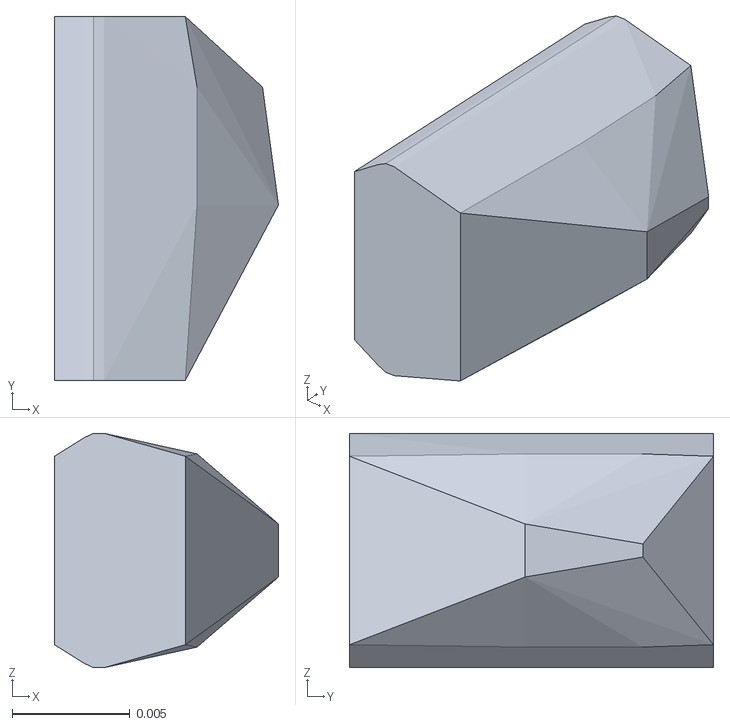
[picture p84: CAD file, 2026-11-06]
parol6_description （机器人模型说明）/parol6_description/meshes/pneumatic/left_finger_link_contact_00.STL
0.00951 x 0.0154 x 0.00995
