pieterseyale-eng/PAROL6-Desktop-robot-arm/parol6_description （机器人模型说明）/parol6_description/meshes/pneumatic/pneumatic_gripper_link.STL

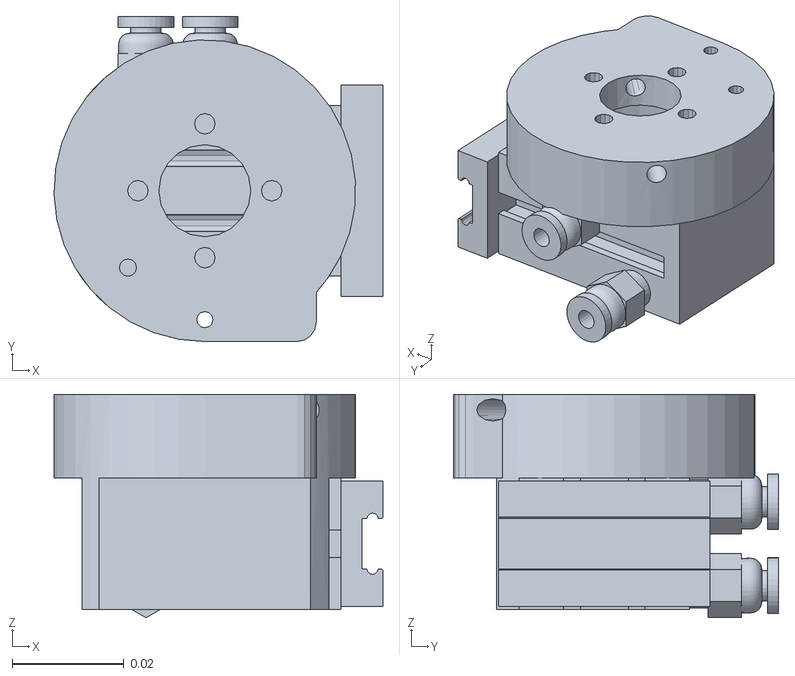
[picture p88: CAD file, 2026-11-06]
parol6_description （机器人模型说明）/parol6_description/meshes/pneumatic/pneumatic_gripper_link.STL
0.059 x 0.0583 x 0.0401
