pieterseyale-eng/PAROL6-Desktop-robot-arm/parol6_description （机器人模型说明）/parol6_description/meshes/pneumatic/right_finger_link_contact_03.STL

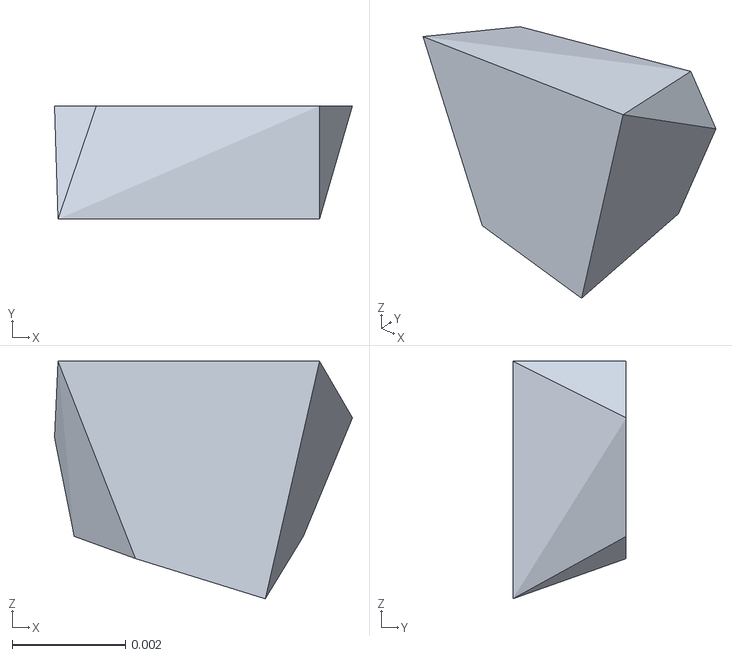
[picture p106: CAD file, 2026-11-06]
parol6_description （机器人模型说明）/parol6_description/meshes/pneumatic/right_finger_link_contact_03.STL
0.00526 x 0.002 x 0.00419
