pieterseyale-eng/PAROL6-Desktop-robot-arm/parol6_description （机器人模型说明）/parol6_description/meshes/pneumatic/right_finger_link_contact_01.STL

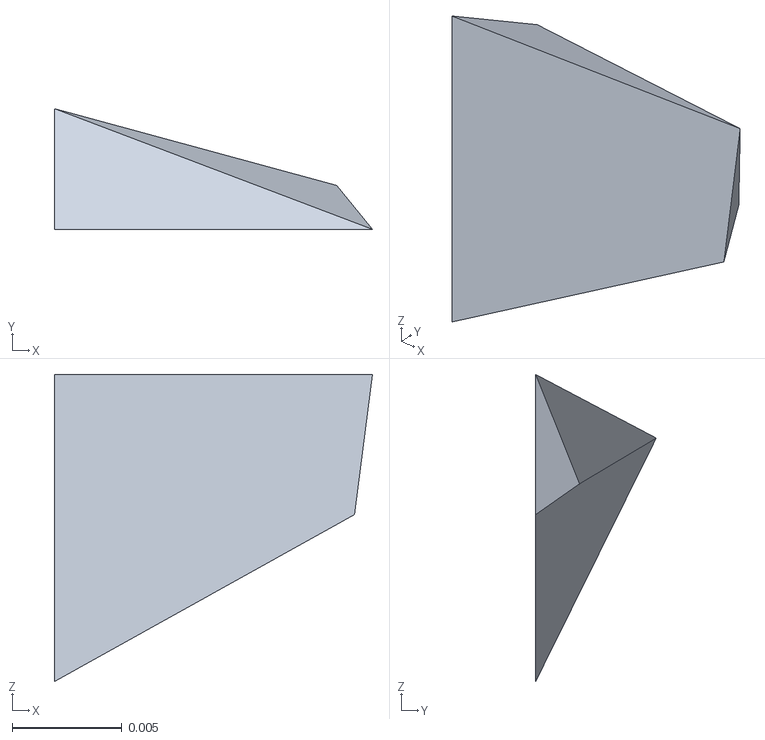
[picture p108: CAD file, 2026-11-06]
parol6_description （机器人模型说明）/parol6_description/meshes/pneumatic/right_finger_link_contact_01.STL
0.0145 x 0.0055 x 0.014
