pieterseyale-eng/PAROL6-Desktop-robot-arm/parol6_description （机器人模型说明）/parol6_description/meshes/pneumatic/right_finger_link_contact_05.STL

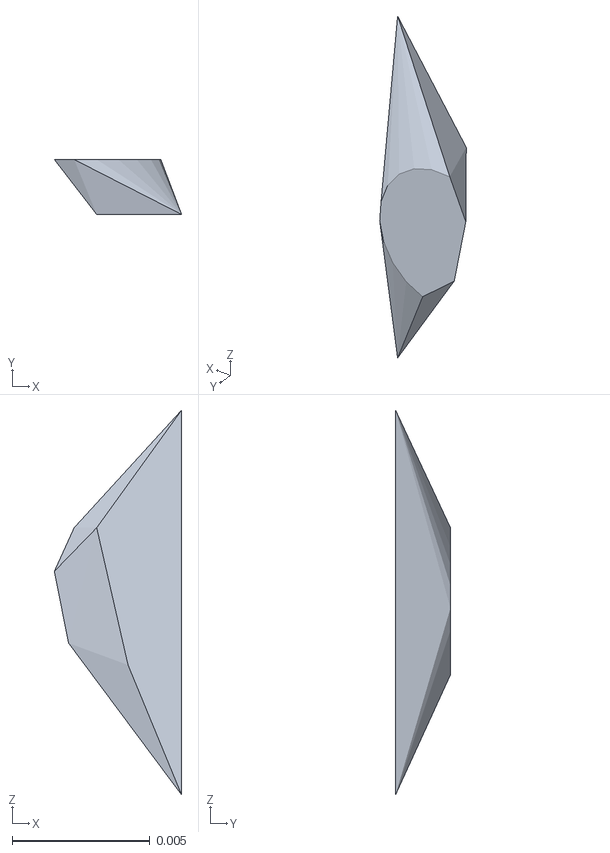
[picture p111: CAD file, 2026-11-06]
parol6_description （机器人模型说明）/parol6_description/meshes/pneumatic/right_finger_link_contact_05.STL
0.00463 x 0.002 x 0.014
