pieterseyale-eng/PAROL6-Desktop-robot-arm/(list of files, cad)

Other CAD files:
parol6_description （机器人模型说明）/parol6_description/meshes/ssg48/jaws/pinch/left.STL
3D打印/分锅STL/锅05_肘部与J4/Elbow_part_motor_cavity_deeper30mm.STL
parol6_description （机器人模型说明）/parol6_description/meshes/contacts/ssg48_fin_ray/left_00.STL
parol6_description （机器人模型说明）/parol6_description/meshes/msg/jaws/tpu_glue/right_carriage.STL
parol6_description （机器人模型说明）/parol6_description/meshes/contacts/msg_soft_tpu/left_00.STL
parol6_description （机器人模型说明）/parol6_description/meshes/contacts/ssg48_solid/left_00.STL
parol6_description （机器人模型说明）/parol6_description/meshes/msg/jaws/tpu_glue/left_hex.STL
parol6_description （机器人模型说明）/parol6_description/meshes/msg/jaws/tpu_glue/left_holder.STL
parol6_description （机器人模型说明）/parol6_description/meshes/contacts/msg_solid/right_03.STL
parol6_description （机器人模型说明）/parol6_description/meshes/contacts/ssg48_solid/right_03.STL
parol6_description （机器人模型说明）/parol6_description/meshes/contacts/msg_soft_tpu/right_00.STL
parol6_description （机器人模型说明）/parol6_description/meshes/pneumatic/right_finger_link_contact_00.STL
parol6_description （机器人模型说明）/parol6_description/meshes/pneumatic/right_finger_link.STL
