pieterseyale-eng/PAROL6-Desktop-robot-arm/Building instructions （装配说明）/中文翻译底稿/manual_zh_pages_001_025.md

# PAROL6 装配手册中文译文（第 1–25 页）

> 译文说明：本译文用于理解装配流程；型号、尺寸、数量及安全要求请与原版 PDF 核对。图中的零件标识保留英文，便于对应 STL 文件。图中文字以可提取的 PDF 文本为准，纯图片标注可能未被提取。

## 第1页

**PAROL6 装配手册**
版本 1.2，修订版 1，日期：2023-10-27

## 第2页

### 免责声明与重要须知

PAROL6 机械臂及其相关零件专为工程开发、演示或评估用途设计，不属于适合一般消费者使用的最终产品。操作这些产品的人员必须接受适当的电子和机器人技术培训，并遵循良好的工程实践。请注意，本产品可能未满足成品通常具备的所有设计、营销和制造相关保护措施，包括产品安全和环境方面的要求。PAROL6 机械臂不符合欧盟关于电磁兼容性、限制有害物质（RoHS）、电子电气设备废弃物回收（WEEE）的指令，也不符合 FCC、CE 或 UL 要求。因此，它可能不满足上述指令或其他相关指令规定的技术要求。

用户对机械臂的正确、安全操作承担全部责任和义务。此外，用户同意就因使用或操作产品而产生的任何索赔，向 Source Robotics 团队提供赔偿并使其免受损害。由于产品采用开放式结构，用户有责任采取所有必要的预防措施。

除上述赔偿义务外，任何一方均不对另一方承担任何间接、特殊、附带或后果性损害的责任。

## 第3页

### 免责声明与重要须知

组装此机械臂前，请先阅读整本手册！本设备可能伤害你及周围的人。如果操作不慎，可能造成烫伤、触电或身体伤害。请仔细阅读这些说明！

阅读手册并完成组装后，也请务必熟悉机械臂控制软件及其操作方式！

## 第4页

### 许可证

机械臂控制软件：链接；STL 文件：链接；控制板软件：均采用 GPLv3 许可证！

PAROL6 的 STEP 文件和 PAROL6 控制板不是开源的！

## 第5页

### 装配手册

欢迎阅读 PAROL6 装配手册。PAROL6 是一款面向教育、研究和小型自动化的六轴机械臂，由 Source Robotics 制作，设计者为 Petar Crnjak。

更多信息请访问：

- GitHub 项目仓库——最新的 BOM（物料清单）、零件、文档和手册。
- 文档页面——PAROL 软件的最新文档。
- 官方公司页面——Source Robotics。

你也可以向社区寻求帮助和建议：

- 官方 Discord 服务器：链接。
- 或发送邮件至：info@source-robotics.com。

你也可以在社交媒体上关注我们：

## 第6页

### 装配手册

图中显示的螺钉尺寸都相同，仅供参考。正确尺寸请阅读对应页面上的说明。部分零件没有画出，主要是轴承、小螺钉和皮带，但会在装配步骤页面中注明。

本文档只包含装配手册；BOM、打印参数表、STL 文件等其他文件可在项目 GitHub 页面找到。

所有零件都应使用 PETG 材料打印。最佳填充率和打印设置请参考打印参数表。

图中未显示电线，但手册提供了详细的布线路径说明。

图中未显示皮带，但手册提供了正确安装皮带的详细说明。

- 此区域显示本页所需零件。
- 此区域显示装配说明。
- 此区域显示提示和备注。

## 第7页

### 装配手册——PAROL6 的组装与使用路线图

机械臂必须从手腕向底座方向组装。也就是说，先组装手腕，再组装前臂、肘部、上臂，最后组装底座。其他组装顺序都不可行。必须这样做，是因为所有线缆都要穿过机械臂内部。

机械臂组装完成后，需要连接 PAROL 控制板。之后即可进行微调和测试。

## 第8页

### 装配手册——打印准备

部分零件需要使用支撑打印。使用这些零件前，请确保清理干净所有支撑材料。

我们使用的打印机设置：

- 打印机：Prusa MK2S。
- 材料：PETG。
- 层高：原文未填写。
- 支撑：参考打印参数表。
- 填充率：参考打印参数表。

## 第9页

### 装配手册——电线与气动管准备

夹爪电线需要使用双绞线。

请尽量按照以下建议，为机械臂各部分准备相应长度的电线。

**电线长度：**

- 电机 J1：4 根线，每根 1 米。
- 传感器 J1：3 根线，每根 1 米。
- 电机 J2：4 根线，每根 1 米。
- J2 限位开关：2 根线，每根 1 米。
- 电机 J3：4 根线，每根 1 米。
- J3 限位开关：2 根线，每根 1 米。
- 电机 J4：4 根线，每根 1 米。
- 传感器 J4：3 根线，每根 1 米。
- 电机 J5：4 根线，每根 1 米。
- J5 限位开关：2 根线，每根 1 米。
- 电机 J6：4 根线，每根 1 米。
- 传感器 J6：3 根线，每根 1 米。
- 气动管：2 根，每根 1 米。
- 夹爪电线：4 根，每根 1 米（组成 2 对双绞线）。

由于机械臂从手腕向底座组装，越接近末端时，已经穿入的线缆就越多。为了保持整洁并便于组装下一段连杆，每完成一段后，用绝缘胶带（我们使用布基线束胶带）把这一组电线缠扎起来。例如完成前臂组装后，用胶带整理 J6 电机线、J5 电机线等。尽量用不同颜色的胶带标记不同关节，这会在连接机械臂电路时帮上很大忙。

组装过程中，线缆会留得比实际需要更长；可将多余部分剪短，以便连接控制板并保持整洁。通常线缆从机械臂底座穿出后，还需要额外留出 8 cm。气动管则留出 15 cm。

## 第10页

### 装配手册——螺钉与零件连接

PAROL6 使用 M3–M5 螺钉连接零件。大多数承力的打印件对打印件连接，采用螺钉配合略小于螺钉直径的 3D 打印孔。

例如右侧图片中，我们用 M3 螺钉连接两个承受载荷的 3D 打印件，而不是装饰件（例如外盖等装饰件即使不装，机械臂也能工作）。此处孔径打印为 2.7–2.8 mm，略小于螺钉直径；拧入螺钉时，螺钉会在 3D 打印件中攻出螺纹。

这种做法有以下优点：

- 与使用丝锥攻牙或黄铜热熔嵌件相比，连接强度最高。
- 简单、快速。
- 无需预先加工孔，可直接打印小孔。

缺点是无法反复拆装很多次。如果感觉螺钉在孔内打滑，可在孔内滴入一些强力胶，等待其固化后再重新攻牙。

大多数金属对金属连接无需额外准备，例如固定步进电机或减速器；这些零件本身已有螺纹孔。将轴联轴器固定到电机轴上时，需要使用蓝色螺纹锁固剂，后续装配手册会进一步说明。也建议在任何与金属配合的螺钉上使用螺纹锁固剂，例如连接电机和减速器的螺钉。

## 第11页

### 装配手册——所需工具

组装机械臂需要以下工具：

- 螺丝刀套装。
- 电钻。
- 电烙铁。
- 内六角扳手（Allen key / HEX key）套装。
- 扭矩螺丝刀。
- 橡胶锤。
- 锤子。
- 钳子。

建议先使用电动螺丝刀拧紧，再用精密扭矩螺丝刀完成最后几圈，或最后几圈用手拧紧。如果所有零件都用电钻或电动螺丝刀拧紧，可能会损坏螺纹。

## 第12页

### 装配手册——所需耗材

- 蓝色螺纹锁固剂。
- 锂基润滑脂。
- 绝缘胶带。
- 焊锡。
- 热缩管。
- 线束。
- 布基线束胶带。

## 第13页

### 装配手册——关节编号与名称

图示关节编号：6、4、5、3、2、1。（编号位置请对照原版图示。）

## 第14页

### 装配手册——布线

机械臂的大部分电线都从机械臂内部穿过。只有红色标出的区域会露出机械臂外部。

## 第15页

### 零件准备

（本页为章节标题页。）

## 第16页

### 限位开关

将限位开关导线焊接到橙色标示的触点上。焊点处套上热缩管。导线长度需为 1 m。

## 第17页

### 附加说明

（本页为章节标题页。）

## 第18页

### 附加说明

- 如果皮带张力不够，可以增加张紧轴承。
- 装配机械臂时会有很多电线。组装过程中，将电线逐步整理成一束，并用绝缘胶带或布基胶带缠扎。
- 如果组装过程中胶带妨碍操作，可先将其拆下，完成该步骤后再重新缠好。
- 尽量给电线做标记，以便组装完成后识别每根线的用途。
- 皮带张紧使用 3×8×4 mm 和 3×10×4 mm 滚珠轴承。根据所需张力，可选择任意组合。轴承必须始终成对安装在一颗长度为 14–20 mm 的螺钉上。（原图此处有指向说明的箭头。）
- 建议使用符合 ISO 4762 规格的螺钉。
- 用于连接减速器和电机的螺钉，使用减速器随附的螺钉。

## 第19页

### 附加说明

PAROL6 机械臂需要执行回零，因为它使用开环步进驱动器。J1、J4 和 J6 通过电感式传感器回零。回零由小螺钉触发：螺钉靠近传感器时会触发信号。你需要找到传感器能够触发的“最佳位置”（sweet spot）。

## 第20页

### 手腕组件

（本页为章节标题页。）

## 第21页

### 手腕组件

**零件与紧固件：**

- Wrist（手腕件）。
- Gearbox 10:1（10:1 减速器）。
- Stepper 1（步进电机 1）。
- Sensor 1（传感器 1）。
- 3 颗 M4×10 mm 螺钉。
- 4 颗 M3×8 mm 螺钉。

首先将步进电机 1 固定到减速器上。减速器自带联轴器，需要用 2 颗紧定螺钉锁紧。用于拧紧这两颗螺钉的孔位于减速器侧面。

接着将传感器 1 压入 Wrist（手腕件）。传感器应平贴在手腕件顶部，位置如箭头 1 所示。

电机和传感器的导线应从箭头 2 标示的孔穿出。

确保步进电机方向与图片所示一致！

减速器和电机之间使用的螺钉为减速器随附螺钉。本装配中所有“减速器＋电机”组件均适用此要求。

## 第22页

### 手腕组件

**零件与紧固件：**

- Bearing 1（轴承 1）。
- M3×14 mm 螺钉（*）。
- M3 螺母（*）。

如果传感器松动，可使用 M3 螺母和螺钉将其固定。

将轴承 1 安装到 Wrist（手腕件）上。组装完成后的部件见下一页。

图示标注：M3×14 mm。

## 第23页

### 手腕组件

PAROL6 机械臂需要执行回零，因为它使用开环步进驱动器。J1、J4 和 J6 通过电感式传感器回零。回零由小螺钉触发：螺钉靠近传感器时会触发信号。你需要找到传感器能够触发的“最佳位置”（sweet spot）。

## 第24页

### 前臂组件

（本页为章节标题页。）

## 第25页

### 前臂组件

**零件：**

- Bearing 2（轴承 2）。
- `J5_part`。

轴承 2 需要安装到箭头 1 标示的凹槽中。组装完成后的部件见下一页。
