pieterseyale-eng/PAROL6-Desktop-robot-arm/Building instructions （装配说明）/中文翻译底稿/manual_zh_pages_026_050.md

## 第26页

### 前臂装配（Forearm assembly）

用橡胶锤将轴承敲入。也可以使用螺丝刀和锤子，沿轴承整个圆周轻轻敲入。

## 第27页

### 前臂装配（Forearm assembly）

零件：`HTD3_48_J5_pulley`。

将 J6 的所有线缆穿过滑轮和轴承！装配完成后的部件见下一页。

## 第28页

### 前臂装配（Forearm assembly）

本页为装配示意图，无可提取的正文。

## 第29页

### 前臂装配（Forearm assembly）

零件：步进电机 2（Stepper 2）。

步进电机线、其他所有线缆及管路都要穿过箭头 1 标示的线缆导向槽，再穿过 `J5` 零件上的孔。

**注意：**图中步进电机的朝向错误。请将电机旋转 180°，使线缆穿过箭头 2 所指的孔。

## 第30页

### 前臂装配（Forearm assembly）

- 4 × M3 × 25 mm
- 4 × M3 × 14 mm

图中标注的两种螺钉各需 4 颗。

## 第31页

### 前臂装配（Forearm assembly）

零件：2 个气动接头 1（Pneumatic connector 1）；限位开关（Limit switch）。

- 2 × M2 × 10 mm

用 M2 螺钉固定限位开关。线缆需要穿过 `J5` 零件上的孔。气动接头用随附螺母固定。气管穿过 `J5` 零件上的孔。

## 第32页

### 前臂装配（Forearm assembly）

零件：`J5_electronics_lid`；电动夹爪连接器（Gripper connector electric）。

在夹爪连接器上焊接 4 根长度为 1 m 的导线。其中 2 根导线需要绞合成 CAN 总线双绞线。焊点使用热缩管绝缘。将夹爪连接器放入盖板后，用随附螺母将连接器固定在盖板上。

将 4 根导线焊接到 4 针连接器，针脚定义如下：

1. 24 V
2. CANH
3. GND
4. CANL

## 第33页

### 前臂装配（Forearm assembly）

- 4 × M3 × 8 mm

装配完成后的部件见下一页。

## 第34页

### 前臂装配（Forearm assembly）

本页为装配示意图，无可提取的正文。

## 第35页

### 前臂装配（Forearm assembly）

**警告：**如果腕部零件上没有安装夹爪，`J5` 看起来可能可以无限旋转。**不要这样做！**`J5` 的运动限位见下方图片。

## 第36页

### 前臂装配（Forearm assembly）

零件：`J4_output_pulley`。

- 6 × M3 × 16 mm

所有线缆和管路都需要穿过 `J4_output_pulley`。使用 M3 × 16 mm 螺钉将滑轮固定到下臂主体上。图中标注：归零销（Homing pin）。

## 第37页

### 前臂装配（Forearm assembly）

本页为装配示意图，无可提取的正文。

## 第38页

### 前臂装配（Forearm assembly）

- 1 × M3 × 6 mm

此螺钉用于触发 `J4` 传感器。请使用随附螺钉。若使用其他螺钉，传感器会在错误的位置触发，从而导致机械臂运动学参数错误。

## 第39页

### 肘部装配（Elbow assembly）

本页为装配示意图。

## 第40页

### 肘部装配（Elbow assembly）

零件：`Elbow_part`。

- 2 个轴承 2（Bearing 2）

## 第41页

### 肘部装配（Elbow assembly）

零件：步进电机 2（Stepper 2）。

- 4 × M3 × 14 mm

用 4 颗螺钉固定步进电机。注意箭头 1 所示的电机线方向。前序步骤和后续步骤中的所有线缆都需要穿过孔 2。

## 第42页

### 肘部装配（Elbow assembly）

零件：`J4_limiter`；传感器 2（Sensor 2）。

- M3 × 12 mm
- M3 × 8 mm

传感器 2 的导线需要穿过箭头 1 所标示的孔。装配完成后的部件见下一页。图中两种螺钉分别标注为 M3 × 8 mm 和 M3 × 12 mm。

## 第43页

### 肘部装配（Elbow assembly）

零件：`J4 pulley`；`J4 belt`。

先将所有线缆和管路穿过肘部零件！当 `J4 pulley` 与 `J4 output pulley` 处于图示位置时，装上皮带。

## 第44页

### 肘部装配（Elbow assembly）

皮带张紧轴承安装在红色标记处！

**使用 M3 × 15 mm 锥头螺钉！**

PAROL6 机械臂需要执行归零，因为它使用开环步进驱动器。关节 1、4 和 6 使用电感式传感器归零。归零由小螺钉触发：螺钉靠近传感器时会触发传感器。需要找到传感器能够触发的“合适位置（sweet spot）”。

## 第45页

### 肘部装配（Elbow assembly）

零件：`Elbow_lid_2`；`J4_bearing_backplate`。

- 2 × M3 × 8 mm
- 4 × M3 × 14 mm

所有线缆和管路需要沿箭头 1 所示方向布置，并从箭头 2 所示位置引出。

## 第46页

### 肘部装配（Elbow assembly）

零件：`Elbow_lid_1`。

- 4 × M3 内六角螺钉（imbus）× 8 mm

## 第47页

### 肘部装配（Elbow assembly）

确认所有关节都可以活动，并且没有某些位置摩擦过大。如果有，请检查：

1. 轴承是否未对准。
2. 轴承压板螺钉是否拧得过紧。
3. 线缆是否缠绕。

## 第48页

### 上臂装配（Upper arm assembly）

本页为装配示意图。

## 第49页

### 上臂装配（Upper arm assembly）

本页为装配示意图。

## 第50页

### 上臂装配（Upper arm assembly）

- 2 个轴承 2（Bearing 2）
- 上臂（Upper arm）

装配完成后的部件见下一页。
