pieterseyale-eng/PAROL6-Desktop-robot-arm/Building instructions （装配说明）/中文翻译底稿/manual_zh_pages_051_075.md

# PAROL6 装配说明中文翻译：第 51–75 页

> 本译文按原手册页码逐页对应。英文零件 ID 保持原样，以便在 STL 文件中查找。纯图示页面需结合原 PDF 同页图片理解。机器翻译仅供装配参考；关键尺寸、紧固件及安全事项以原版手册和实物核对为准。

## 第51页

**上臂装配（Upper arm assembly）**。本页为章节图示页，请对照原 PDF 图片。

## 第52页

**上臂装配（Upper arm assembly）**

- 零件：`38_pulley_J3`
- 螺钉：M3 × 35 mm 或 M3 × 38 mm，共 6 颗。

## 第53页

**上臂装配（Upper arm assembly）**

- 步进电机 2（Stepper 2）
- 20:1 减速器（Gearbox 20:1）
- M3 × 8 mm 螺钉 4 颗；M4 × 16 mm 螺钉 4 颗。
- 确保步进电机带电线的一侧朝向箭头所示方向。
- 原图两处均标有 M3 × 8 mm 4 颗、M4 × 16 mm 4 颗；请结合装配位置核对，避免重复计数。

## 第54页

**上臂装配（Upper arm assembly）**

- 零件：`J3_limit_switch_cover`
- 限位开关（Limit switch）
- M3 × 8 mm 螺钉 3 颗；M2 × 10 mm 螺钉 2 颗。
- 限位开关导线穿过箭头 1 标记的孔。步进电机导线穿过标记 2 的孔。完成后的部件见下一页。

## 第55页

**上臂装配（Upper arm assembly）**。本页为装配结果图示，请对照原 PDF 图片。

## 第56页

**上臂装配（Upper arm assembly）**

将上臂组件连接到前臂组件。用布基胶带包束导线。导线需从箭头 1 所指的孔穿入，再经过箭头 2 所指的槽。导线应沿蓝线所示路径布置。

**注意：**J3 限位开关导线与 J3 步进电机导线必须穿过同一个槽。

## 第57页

**上臂装配（Upper arm assembly）**

- 零件：`Upper_arm_wires_cover`
- M3 × 12 mm 螺钉 4 颗。
- 用上臂线缆盖板包住导线，并确保导线收紧、不松散。装配完成后的部件见下一页。

## 第58页

**上臂装配（Upper arm assembly）**

导线收纳好后，尝试转动关节 3。皮带将在后续步骤中安装。

## 第59页

**肩部装配（Shoulder assembly）**。本页为章节图示页，请对照原 PDF 图片。

## 第60页

**肩部装配（Shoulder assembly）**

- 零件：`J1_turret_motor_holder`
- 步进电机 3（Stepper 3）
- 20:1 减速器（Gearbox 20:1）
- M3 × 8 mm 螺钉 4 颗；M4 × 16 mm 螺钉 4 颗。
- 先将步进电机安装到减速器上，再将转台电机支架安装到减速器上。装配完成后的部件见下一页。
- 原图两处均标有 M3 × 8 mm 4 颗、M4 × 16 mm 4 颗；请结合图示核对紧固件数量。

## 第61页

**肩部装配（Shoulder assembly）**

步进电机导线应按图示方向和位置布置。请对照原 PDF 图片。

## 第62页

**肩部装配（Shoulder assembly）**

- 法兰联轴器（Shaft coupler）
- M4 × 16 mm 螺钉 4 颗（原图标注两处）。
- 注意标记 1 的孔位。该孔按图示方向定位，便于后续拧紧螺钉。

## 第63页

**肩部装配（Shoulder assembly）**

法兰联轴器应与孔对齐。此处需使用蓝色螺纹锁固剂（blue threadlocker），最好静置数小时使其固化。

## 第64页

**肩部装配（Shoulder assembly）**

减速器有一个供键使用的槽（键槽，keyway）。由于本设计不安装键，必须确保法兰联轴器的紧定螺钉拧入该键槽位置。此处使用螺纹锁固剂。

## 第65页

**肩部装配（Shoulder assembly）**

- 零件：`J1_turret`、`J1_rotation_shaft`
- M4 × 16 mm 螺钉 6 颗；M4 × 14 mm 螺钉 1 颗。
- M4 × 14 mm 螺钉用于 J1 归零。拧入后，螺钉应在底侧略微突出；**不要将螺钉完全拧到底**。
- 原图注明：M4 × 14 mm 用于 J1 归零。

## 第66页

**肩部装配（Shoulder assembly）**

- 步进电机 3（Stepper 3）
- 限位开关（Limit switch）
- 零件：`J2_limit_switch_cover`
- M3 × 8 mm 螺钉 2 颗；M3 × 14 mm 螺钉 4 颗；M2 × 10 mm 螺钉 2 颗。
- 安装盖板前，先用 2 颗 M2 螺钉固定限位开关。随后将其导线穿过 `J1_rotation_shaft`。注意导线位置。
- 用 2 颗 M2 × 10 mm 螺钉固定限位开关。

## 第67页

**肩部装配（Shoulder assembly）**。本页为图示页，请对照原 PDF 图片。

## 第68页

**肩部装配（Shoulder assembly）**

- 零件：`J2_stopper_block`
- M3 × 8 mm 螺钉 1 颗；M3 × 12 mm 螺钉 2 颗。

## 第69页

**肩部装配（Shoulder assembly）**。本页为图示页，请对照原 PDF 图片。

## 第70页

**肩部装配（Shoulder assembly）**

- Bearing 3（轴承 3）× 2。

## 第71页

**肩部装配（Shoulder assembly）**。本页为图示页，请对照原 PDF 图片。

## 第72页

**肩部装配（Shoulder assembly）**

- M4 × 16 mm 螺钉 2 颗；M4 × 14 mm 螺钉 2 颗。
- 新版本的 `J1_turret` 已作修改，加入了用于 J1 限位块（stopper）的导轨。
- 原图另标出 M4 × 14 mm、M4 × 16 mm；请结合图示确认每种螺钉的安装位置。

## 第73页

**肩部装配（Shoulder assembly）**。本页为图示页，请对照原 PDF 图片。

## 第74页

**肩部装配（Shoulder assembly）**

- M3 螺钉 1 颗，长度原文标为“？”（`1 x M3 ?`），长度未注明。
- **此步骤并非必需。**

## 第75页

**肩部装配（Shoulder assembly）**

- 零件：`J2_shaft`
- M4 × 50 mm 螺钉 4 颗。
