pieterseyale-eng/PAROL6-Desktop-robot-arm/(commit log)

2026-11-05 Add Chinese PAROL6 docs and P1S print preparation
2026-11-06 Organize robot arm files and add J5 print and CAN control updates
2026-11-07 Add deepened elbow motor pocket and manufacturing BOM
2026-11-11 Record J5 connector clearance and save updated print models
2026-11-11 Record CAN controller purchases and wrist connector relief
2026-11-13 Document PAROL6 control wiring discussion
2026-11-13 Update J1 turret blocker print file
