pieterseyale-eng/PAROL6-Desktop-robot-arm/(notices)

Notices in the files:
README.md:
Firmware: GPL-3.0
